jmdmahdi/Weather-Station/README.md

# Weather Station
Weather station (measure pressure, temperature, light intensity, wind speed and direction) with STM32 MCU (in STM32CubeIDE)
