jmdmahdi/Weather-Station/Desktop App/README.md

# Desktop App
Weather station desktop app with Python, PyQt5, and PyUSB

Gather data on the receiver side (station) form STM32 MCU through USB protocol
