jmdmahdi/Weather-Station/Codes/Sensor/README.md

# Sensor
Weather station sensor side (transmitter)

STM32 MCU collects data from sensors and transmits them through Lora module to the station
