jmdmahdi/Weather-Station/Codes/Station/README.md

# Staion
Weather station side (receiver)

STM32 MCU collects receive data from LoRa module and transmit it to the desktop app through USB protocol
