jmdmahdi/Weather-Station/Report/Assets/Diagram.pdf

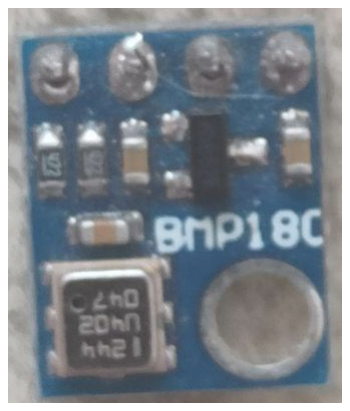
[picture p1: figure]
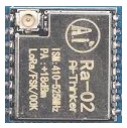
[picture p2: figure]
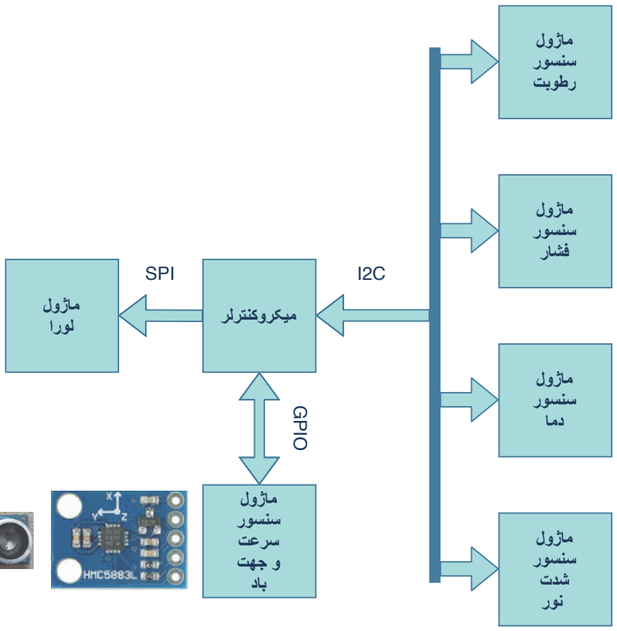
[picture p3: figure]
ماژول; میکروکنترلر; لورا; ماژول سنسور دما; ماژول سنسور فشار; ماژول سنسور رطوبت; ماژول سنسور شدت نور; ماژول سنسور سرعت جھت; باد; GPIO; SPI
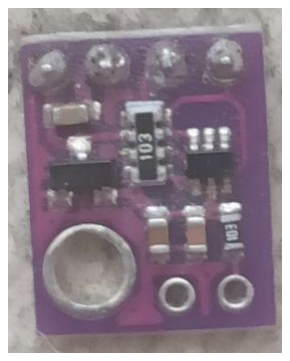
[picture p4: figure]
