jmdmahdi/Weather-Station/Report/Assets/USB.pdf

Host

Hub | Device 1 | Device 2
Device 3 | Device 4
