jmdmahdi/Weather-Station/Report/main.pdf

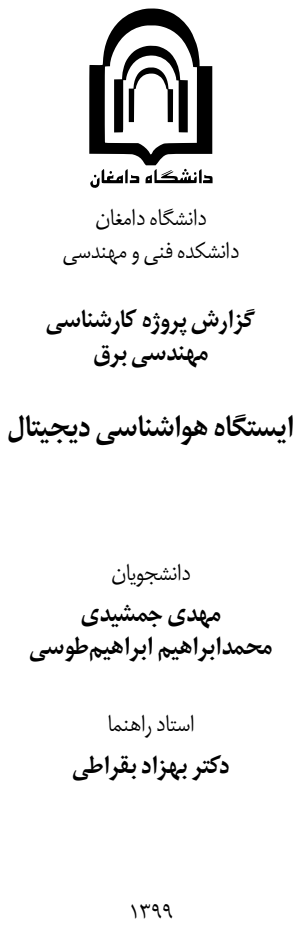
[picture p5: page 1]

دانشگاه دامغان
دانشکده فنی و مهندسی
گزارش پروژه کارشناسی
مهندسی برق
ایستگاه هواشناسی دیجیتال

دانشجویان
مهدی جمشیدی
محمدابراهیم ابراهیم طوسی

استاد راهنما
دکتر بهزاد بقراطی

## فهرست مطالب

### ۱ مقدمه ۱ ۲ اجزای سیستم ۱

### ۳ پروتکل های ارتباطی ۶

۷ | I

.۳ ۲ پروتکل C²

### ۴ پیاده سازی سیستم ۹ ۵ طراحی بردمدارچاپی ۱۱ ۶ نتایج ۱۲ ۷ نتیجه گیری ۱۳

اول

## ۱ مقدمه

ایستگاه هواشناسی، مرکزی مجهز به تجهیزات و ابزارهایی برای اندازه گیری های جوی است که به ارائه اطلاعات برای پیش بینی ً شامل دما، فشار هوا، رطوبت، سرعت باد، جهت باد و مقدار بارش است.
و مطالعه آب وهوا می پردازد. اندازه گیری انجام شده معمولا مشاهدات دستی حداقل یک بار در روز انجام می شود، درحالی که اندازه گیری خودکار حداقل یک بار در ساعت انجام می پذیرد. ایستگاه های هواشناسی معمولی مجهز به ابزارهای زیر هستند [۱]:
- رطوبت سنج برای اندازه گیری رطوبت
- فشارسنج برای اندازه گیری فشار جو
- دماسنج برای اندازه گیری دمای هوا
- پیرانومتر برای اندازه گیری تشعشعات خورشیدی
- باران سنج برای اندازه گیری میزان بارش باران در طی یک دوره زمانی مشخص
- تجهیزاتی نظیر بادسنج، پرچم باد یا جوراب باد برای اندازه گیری سرعت و جهت باد ایستگاه های پیشرفته تر همچنین ممکن است شاخص فرابنفش، رطوبت برگ، رطوبت خاک، دمای خاک، دمای آب در حوضچه ها، دریاچه ها، نهرها یا رودخانه ها و گاهی داده های دیگر را اندازه گیری کنند. به جز دستگاه هایی که نیازمند تماس مستقیم با عناصر مورداندازه گیری هستند (نظیر بادسنج)، دیگر سنسورها و دستگاه ها باید در محفظه ای به دوراز تابش مستقیم خورشید و وزش باد قرار بگیرند. ایستگاه های هواشناسی سینوپتیک (Synoptic (۲۴ ساعته به صورت خودکار هر سه ساعت به سه ساعت پارامترهای جوی
را پس از اندازه گیری و جمع آوری از طریق شبکه های مخابراتی منتقل می کنند. به طور مشابه ایستگاه هایی با نام متار (Metar( این کار را هر یک ساعت انجام می دهند. وظیفه این ایستگاه ها جمع آوری اطلاعات جوی از محدوده هایی وسیع و مخابره به ایستگاه های اصلی به منظور اطلاع از وضعیت حال و گذشته و پیش بینی شرایط آب و هوایی مناطق در آینده است. هدف این پروژه پیاده سازی نوعی ایستگاه هواشناسی سینوپتیک است که با تجهیزات ارزان و کم مصرف دیجیتالی پارامترهای جوی لازم را جمع آوری و به صورت بی سیم به ایستگاهی جهت ثبت و نمایش مخابره می کند. در این پروژه از میکروکنترلر (Microcontroller (ARM سری X10F32STM به عنوان هسته اصلی پردازش در هر دو سمت سنسور و ایستگاه و از ماژول لورا (LoRa (با چیپ 1278SX به منظور برقراری ارتباط بی سیم استفاده شده است.

## ۲ اجزای سیستم

این سیستم به دو دستگاه اصلی تقسیم می شود، یک دستگاه جهت جمع آوری اطلاعات جوی برروی یک میله در ارتفاع ۱۰ متری سطح زمین قرار می گیرد و اطلاعات جوی نظیر دما، رطوبت، فشار، شدت نور، سرعت و جهت باد را از سنسورهای مربوطه جمع آوری کرده و به صورت بی سیم به دستگاه دیگر، که در ایستگاه اصلی قرار دارد، مخابره می کند؛ سپس اطلاعات دریافت شده در سمت دستگاه دوم جهت ثبت و ذخیره به رایانه منتقل می شود. در اینجا به دستگاه اول که وظیفه جمع آوری اطلاعات جوی را دارد سنسور و دستگاه دوم که وظیفه دریافت اطلاعات مخابره شده و انتقال به رایانه را دارد ایستگاه می گوییم. بلوک دیاگرام کلی این سیستم و نحوه ارتباط بخش های مختلف با یکدیگر در شکل ۱ آمده است.

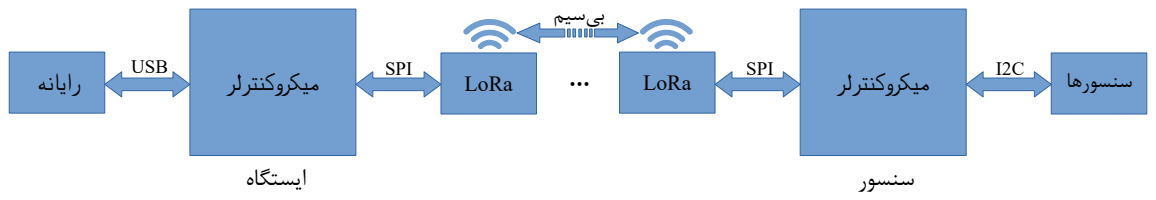
[picture p6: figure]
USB; میکروکنترلر رایانه; LoRa; SPI; میکروکنترلر SPI; سنسورها I2C; سنسور ایستگاه; بی‌سیم

شکل :۱ بلوک دیاگرام اجزای سیستم و نحوه ارتباط اجزای مختلف با یکدیگر.
.۲ ۱ میکروکنترلر
هسته اصلی پردازش در هر دو سمت ایستگاه و سنسور میکروکنترلر 6CBT103f32STM انتخاب شده است که با توجه به ،۲ اینترفیس۳USB۴ و ۳ عدد تایمر ۱۶ بیتی نیاز به حداقل ۱ عدد

،۱ ۲ عددSPI
I

موجود بودن در بازار ایران و دارا بودن ۲ عددC²
I) در سمت سنسور)، ۱ عدد SPI) در هر دو سمت)، اینترفیس USB) در سمت ایستگاه) و ۱ عدد تایمر (در سمت سنسور)
2C
را برآورده می کند. همچنین حالت Sleep و واحد RTC موجود در این میکروکنترلرها به کاهش مصرف انرژی در وقفه های سه ساعته کمک می کند؛ به طوری که استفاده از سیستم باتری و پنل خورشیدی را ممکن می سازد. .۲ ۲ ارتباط بی سیم
به طورکلی در این سیستم مصرف پایین انرژی به دلیل استفاده از سیستم باطری و پنل خورشیدی بسیار اهمیت دارد. استفاده ۵ به عنوان راه حلی ابتدایی برای ارتباط بی سیم، علاوه بر نداشتن صرفه اقتصادی مصرف انرژی زیادی را به
از شبکه تلفن همراه
سیستم تحمیل می کند. همچنین تضمینی برای وجود پوشش شبکه تلفن همراه در مناطقی که قرار است داده های جوی از آن جمع آوری شود وجود ندارد. ازاین رو بهترین رویکرد استفاده از گیرنده و فرستنده های رادیویی در باندهای فرکانسی بدون نیاز به ۶ به لطف مدولاسیون ⁷CSS که از آن بهره می برند دارای مصرف
مجوز (ISM (است. از میان گزینه های موجود ماژول های لورا ً با نیازهای ما سازگار است. توان پایین، ناحیه پوشش وصیع و نفوذپذیری مناسبی هستند که کاملا ماژول -02Ra LoRa با تراشه 1278Sx دارای رنج فرکانسی ۴۱۰ تا ۵۲۵ مگاهرتز، و توان انتقالی ماکسیموم ۱۸dBm وOOK۹ پشتیبانی می کند. برای ارتباط بی سیم در این پروژه از این ماژول استفاده شده

۸
است و از مدولاسیون هایLoRa،FSK است.
.۲ ۳ سنسورها
به منظور استخراج داده های جوی نظیر دمای هوا، رطوبت، فشار، شدت نور و... از سنسورهای دیجیتال استفاده می شود. این سنسورها علاوه بر کم مصرف بودن دارای دقت بالا و تأخیر پایینی در اندازه گیری پارامترهای موردنظر هستند. با دارا بودن این ً با سیستم تغذیه باتری و سلول خورشیدی سازگار هستند. ویژگی ها این سنسورها کاملا

.۲ .۳ ۱ فشارسنج
تغییرات فشار جوی یکی از عناصر مهم در پیش بینی وضعیت آب وهوا است. فشارسنج های جیوه ای از اواخر قرن ۱۶ جهت پیش بینی وضعیت آب وهوا مورداستفاده قرار می گرفت. به طورکلی تغییر فشار هوا رو به بالا نشان دهنده آسمان آفتابی، گرم و صاف

1
Inter-Integrated Circuit
2Serial Peripheral Interface

3
Interface
4Universal Serial Bus
5The Global System for Mobile Communications (GSM) 6LoRa (Long Range)
7Chirp Spread Spectrum
8Frequency Shift Keying
9On Off Keying

و تغییر فشار هوا رو به پایین نشان دهنده بارش باران، طوفان و آسمانی مملو از ابرهای باران زا است. علاوه بر این فشار هوا یکی از عوامل مؤثر در سنجش سرعت باد نیز به شمار می آید. سنسور استفاده شده برای این منظور ماژول سنسور 180BMP است که با مصرف جریان تنها در حد چند میکرو آمپر دقتی معادل با ۰٫۳ هکتوپاسکال۱ دارد و توانایی اندازه گیری فشار هوا در بازه ۳۰۰ تا ۱۱۰۰ هکتوپاسکال را دارا است. نحوه ارتباط با I است.

این ماژول از طریق رابط C²

.۲ .۳ ۲ شدت نور
شدت نور خورشید یکی از پارامترهای اصلی سنجش وضعیت آب وهوا است. از این سنسور جهت نشخیص ابری یا آفتابی بودن ً در کنار این سنسور از سنسور سنجش شدت
هوا می توان استفاده کرد. همچنین به دلیل اهمیت موضوع سلامت پوست، معمولا UV به منظور اطلاع رسانی شدت UV نیز استفاده می شود. جهت سنجش شدت نور از ماژول سنسور 44009MAX استفاده شده است که با ۰٫۶۵ میکرو آمپر مصرف جریان در هنگام کارکرد شدت نور در بازه ی ۰٫۰۴۵ لوکس تا ۱۸۸ هزار لوکس را اندازه گیری می کند. همچنین اینترفیس ارتباطی این ماژول رابط I می باشد.

سریالی C²

.۲ .۳ ۳ قطب نما
ً در ارتفاع ۱۰ متری زمین روی یک میله نصب می شود، قرار دادن دستگاه در
ازآنجایی که این دستگاه در سمت سنسور معمولا جهت جغرافیایی خاص، به جهت سنجش جهت باد، ممکن است دشوار باشد (یا حتی خیلی دقیق نباشد). باوجود سنسور قطب نما در این دستگاه (برخلاف برخی دستگاه های مشابه) دیگر نیازی به نصب دستگاه در جهت جغرافیایی خاص نخواهد بود. سنسور استفاده شده برای این منظور سنسورL5883QMC است. که با ماکسیموم ۱۰۰ میکرو آمپر جریان مصرفی می توان
I است.

به دقت یک تا دو درجه در جهت یابی رسید. همچنین طریقه ارتباط این سنسور با میکروکنترلر از طریق رابط C²

.۲ .۳ ۴ دما و رطوبت هوا
ً به طور مستقیم پارامتر دمای هوا نیز در اطلاع رسانی وضعیت و درکتار وضعیت آسمان (ابری، آفتابی، بارانی و... بودن) معمولا ً به طور مستقیم
پیش بینی آب وهوا نقش ایفا می کند. در کنار این موارد رطوبت هوا نیز، علاوه بر نقشی که در پیش بینی دارد، معمولا به سمع و نظر مخاطبین می رسد. علاوه این رطوبت نسبی هوا در کنار دمای هوا نقش مهمی در رسیدن به آسایش حرارتی در بدن انسان (و موجودات) دارد. به طوری کلی در دمای هوای بالاتر به رطوبت نسبی کمتری نسبت به دمای هوای پایین تر برای رسیدن به سطح آسایش حرارتی نیاز است [۲]. ماژول سنسور 10AHT دما و رطوبت نسبی هوا را با دقت ۰٫۰۱ درجه سلسیوس۲ و ۰٫۰۲۴ درصد با تنها ۳٫۳ میکرو وات مصرف توان اندازه گیری می کند. همچنین این ماژول در رطوبت ۰ تا ۱۰۰ درصد و دمای -۴۰ تا ۱۰۰ درجه ی سلسیوس I است.

قابل استفاده است. خروجی این ماژول نیز سیگنال دیجیتال ارتباطی C²

.۲ .۳ ۵ شدت و جهت باد
ً در این کاربرد دو روش سنجش مکانیکی و آلتراسونیک ۳ مورداستفاده
روش های مختلفی برای سنجش شدت باد وجود دارد، عمدتا قرار می گیرد. در سنجش شدت و جهت باد در روش مکانیکی از دو ابزار که به صورت مستقل کار می کنند (در برخی موارد این دو ابزار در قالب یک دستگاه در کنار هم قرار می گیرند) استفاده می شود، به طوری که یک ابزار برای سنجش شدت و ابزاری دیگر برای تعیین جهت، مورداستفاده قرار می گیرد. هر دو دستگاه دارای قطعات متحرک اند و یکی با داشتن پره هایی شبیه به دم هلی کوپتر با وزرش باد در جهت وزش قرار می گیرد و دیگری دارای پره هایی است که با وزش باد پره ها همانند پره های توربین به حرکت درمی آید که با توجه به سرعت چرخش پره ها سرعت باد قابل اندازه گیری است. در اندازه گیری های این دستگاه ها

1Hectopascal (hPa)
2Celsius
3Ultrasonic

محدودیت هایی وجود دارد و اغلب این نوع ابزارها در وزش باد ملایم عملکرد صحیحی از خود نشان نمی دهند. همچنین در اندازه گیری زاویه وزش ممکن است محدود به اندازه گیری زوایای خاصی باشند. در روش اندازه گیری شدت و جهت باد با آلتراسونیک اندازه گیری ها می تواند در قالب تنها یک دستگاه، بدون قطعات متحرک
و با دقتی بالاتر انجام پذیرد. در این روش ۲ فرستنده و گیرنده آلتراسونیک همان طور که در شکل ۲ نشان داده شده است روبروی یکدیگر در فاصله مشخص d قرار داده می شوند.

فرستنده گیرنده

d

امواج آلتراسونیک

شکل :۲ نحوه قرارگیری فرستنده و گیرنده آلتراسونیک.
فرستنده امواج صوتی با فرکانس ۴۰ کیلوهرتز (که برای گوش انسان قابل شنیدن نیست) تولید می کند. فاصله زمانی بین ارسال امواج صوتی از فرستنده و دریافت این امواج در گیرنده اندازه گیری می شود. با توجه به رابطه ،۱ سرعت v با داشتن فاصله d و زمان تأخیر بین ارسال موج صوتی در فرستنده و دریافت آن در گیرندهt، قابل اندازه گیری است.

v =

d
t

(۱)

سرعت v به دست آمده از این رابطه مطابق رابطه ۲ متشکل از سرعت صوت vs و سرعت باد vwx است [۳].

v = vs + vwx | (۲)
درصورتی که وزش باد در جهت موافق حرکت امواج صوتی باشد زمان تأخیر در دریافت امواج نسبت به حالی که باد نوزد کمتر شده و درنتیجه سرعت v نسبت به حالتی که باد نوزد افزایش می یابد (یعنی علامت vwx مثبت بوده و vwx + vs = v(. درصورتی که وزش باد در خلاف جهت حرکت امواج صوتی باشد زمان تأخیر در دریافت امواج نسبت به حالتی که باد نوزد بیشتر شده و درنتیجه سرعت v کاهش می یابد (یعنی علامت vwx منفی بوده و vwx − vs = v(. با داشتن سرعت صوت vs، فاصله d و محاسبه زمان tمی توان با توجه به معادلات۱ و ۲ سرعت باد vwx و جهت باد (علامت سرعت vwx (روی یک محور مطابق رابطه ۳ به دست آورد.

vwx =

d
t
− vs | (۳)
به منظور سنجش شدت و جهت باد در دو بعد می توان دو فرستنده و گیرنده دیگر بر روی محوری عمود بر محور متصل کننده فرستنده و گیرنده فعلی قرارداد و با محاسبه دو بردار سرعت، بردار سرعت برآیند را به دست آورد. اگر نحوه قرارگیری فرستنده و گیرنده ها مطابق شکل ۳آ باشد در این صورت صفحه مختصات متناظر با آن مطابق شکل ۳ب خواهد بود. اندازه vw و زاویه θ بردار سرعت باد از طریق روابط ۴ به دست می آیند.

vw =

√
v

2
wx + v

2
wy

θ = tan−1

(
vwy
vwx) | (۴)

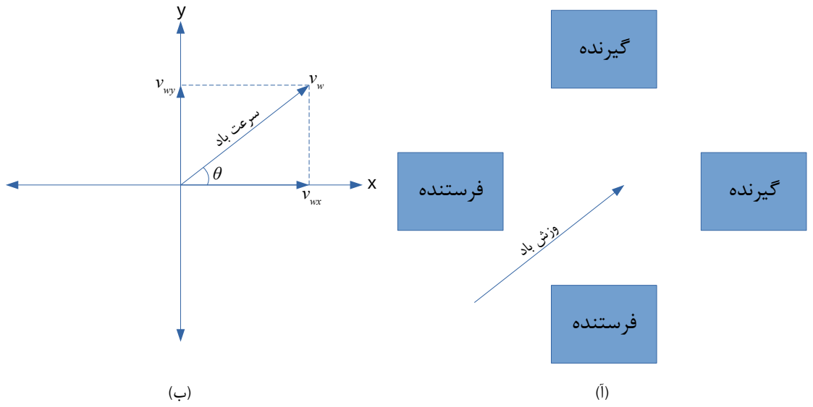
[picture p7: figure]
سرعت باد; گیرنده فرستنده; فرستنده; گیرنده; وزش باد

شکل :۳ نحوه قرارگیری فرستنده و گیرنده آلتراسونیک دو محوره و نمودار متناظر با آن ها. جدول :۱ ضرایب محاسبه سرعت صوت (فرمول ۵) [۴]. ضرایب
331.5024 | a0
0.603055 | a1
−0.000528 | a2
51.471935 | a3
0.1495874 | a4
−0.000782 | a5
−1.82 × 10−7 | a6
3.73 × 10−8 | a7
−2.93 × 10−10 | a8
−85.20931 | a9
−0.228525 | a10
5.91 × 10−5 | a11
−2.835149 | a12
−2.15 × 10−13 | a13
29.179762 | a14
0.000486 | a15
سرعت صوت vs به عنوان تابعی از دما، فشار و کسر مولی رطوبت و کربن دی اکسید، با استفاده از رابطه ۵ قابل محاسبه است [۴]. ثوابت1a تا 15a در جدول ۱ آمده اند.

vs (τ, p, xw, xc) =a0 + a1τ + a2τ

2 +

(
a3 + a4τ + a5τ

2

)
xw
+

(
a6 + a7τ + a8τ

2

)
p +

(
a9 + a10τ + a11τ

2

)
xc
+ a12x

2
w + a13p

2 + a14x

2
c + a15xwpxc

(۵)

xc کسر مولی

که τ دمای هوا (برحسب درجه سلسیوس)، p فشار هوا (برحسب پاسکال)، xw کسر مولی بخارآب در هوا و 10−6 × 400 در نظر می گیریم. کسر مولی بخارآب در هوا xw از رابطه ۶ xc را ثابت و برابر

کربن دی اکسید در هوا است.

به دست می آید [۵].

xw =

hfpsv
100p

(۶)

که h درصد رطوبت هوا، psv فشار اشباع بخارآب در هوا و f ضریب تقویت است و از طریق روابط ۷ و ۸ محاسبه می شوند .[۶]

f = 1.00062 + 3.14 × 10−8

p + 5.6 × 10−7
τ

2
(۷)

psv = exp (
1.2811805 × 10−5T

2 − 1.9509874 × 10−2T

+34.04926034 − 6.3536311 × 10³

/T) | (۸)

که در این روابط T دمای محیط برحسب کلوین۱ است، یعنی:

T = τ + 273.15 | (۹)

## ۳ پروتکل های ارتباطی

قطعات الکترونیک نیز همانند انسان ها برای ارتباط با یکدیگر باید از یک زبان واحد قابل فهم برای هر دو طرف استفاده کنند که به این زبان ها پروتکل های ارتباطی گفته می شود. در این پروژه نیز همانند اکثر پروژه های الکترونیکی از تعدادی از این پروتکل ها برای برقراری ارتباط بین قطعات الکترونیکی مختلف (سنسورها، فرستنده-گیرنده های رادیویی و میکروکنترلر) استفاده شده است. در زیر اطلاعات کلی هر یک از پروتکل های ارتباطی استفاده شده در این پروژه آمده است. .۳ ۱ پروتکل SPI
این پروتکل یک رابط ارتباط سریالی سنکرون۲ (همزمان) چهار سیم است که برای ارتباط بین تنها یک Master و چندین Slave ۳)، خط ارسال داده
می تواند مورداستفاده قرار گیرد. خطوط ارتباطی بین Master و Slave شامل خط سیگنال کلاک (SCLK ۶ یا CS۷(.

از Master به Slave) MOSI۴(، خط ارسال داده از Slave بهMaster) MISO۵ (و خط انتخاب Slave) SS ً نیاز به یک پین انتخاب گر (SS یا CS (مجزا در سمتMaster خواهد بود.
در حالتDuplex Full به ازای هر Slave معمولا نحوه اتصال دستگاه های SlaveبهMaster در شکل ۴ آمده است. سیگنال کلاک همواره توسط Master تولید و به ازای هر سیگنکال کلاک یک بیت داده منتقل می شود. ازاین رو ارسال داده از Slave بهMaster به طور تصادفی و در هرلحظه ممکن نیست و تنها Slave می تواند در لحظاتی کهMaster درخواست می کند و سیگنال کلاک را تولید می کند داده را برروی خط MISO ارسال کند. البته به دلیل وجود خطوط مجزای ارسال و دریافت داده، ارسال و دریافت همزمان داده نیز ممکن است. همچنین در این پروتکل دستگاه های Slave به تنهایی نمی توانند با یکدیگر ارتباط برقرار کنند.

1Kelvin

2
synchronous
3Serial Clock
4Master Out Slave In
5Master In Slave Out
6Slave Select
7Chip Select

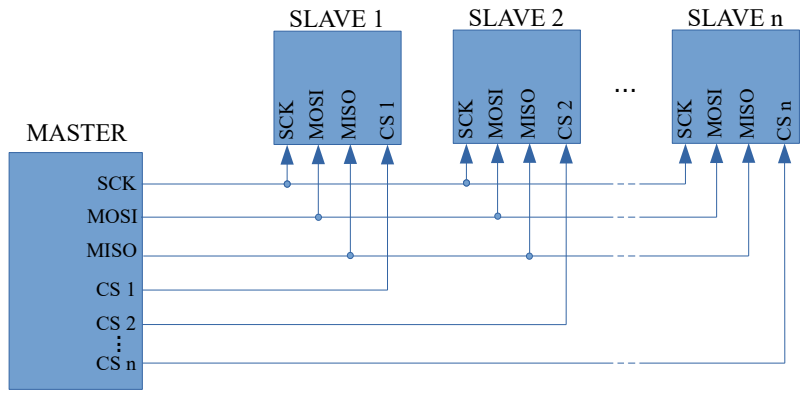
[picture p8: figure]
MASTER; SLAVE 1; SCK; MOSI; MISO; MIS; SLAVE 2; SLAVE n

شکل :۴ نحوه اتصال Slaveها بهMaster در حالت Duplex Full

به جهت ارسال داده، Master از طریق قراردادن خط SS) یا CS (در حالت low انتخاب می کند که با کدام Slave
می خواهد ارتباط برقرار کند. وضعیت خط را تا پایان فرآیند ارسال و دریافت داده در همین حالت (low (نگهمیدارد. در همین حال سیگنال کلاک را روی خط SCLK متناسب با طول داده ارسالی قرار می دهد (ماکسیموم فرکانس کلاک بستگی به ماکسیموم مقدار قابل شناسایی توسط Slave دارد) و داده ارسالی را نیز متناسب با کلاک روی خط MOSI قرار می دهد (قرار دادن داده روی لبه بالارونده یا پایین رونده و همچنین ارسال از بیت MSB یا LSB بستگی به Slave دارد)؛ اگر قرار باشد Slave دیتایی در پاسخ به دیتای دریافتی ارسال کند (این امر باید از قبل مشخص باشد چراکه همان طور که گفته شد مسئول تولید کلاک فقط Master است) باید Master کلاک هایی متناسب با دیتای مورد انتظار برای دریافت را روی خط SCLK تولید کند و دیتای مربوطه را از روی خط MISO بخواند.

I

.۳ ۲ پروتکل C²
I رابط سریالی سنکرون دو سیم است که علاوه بر پشتیبانی از چندین Slave قابلیت پشتیبانی از چند Master را

پروتکل C²
نیز دارا می باشد (البته Masterها قادر به برقراری ارتباط با یکدیگر نیستند و از خطوط بأس به طور همزمان نمی توانند استفاده
۲) استفاده می شود. نحوه اتصال
۱) و سیگنال دیتا (SDA
کنند). در این پروتکل برای ارتباط از تنها دو خط سیگنال کلاک (SCL دستگاه ها در این پروتکل در شکل ۵ آمده است.

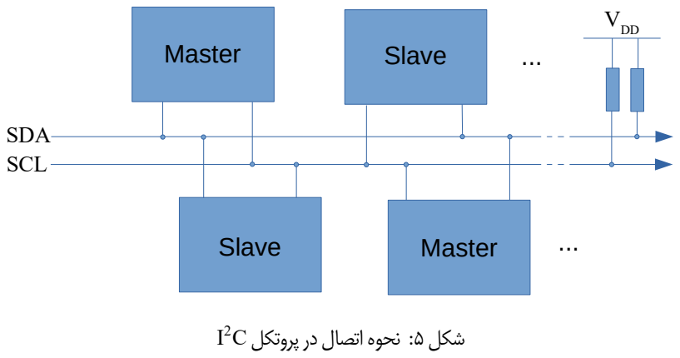
[picture p9: figure]
SDA SCL; Master; Slave; VDD; شکل :۵ نحوه اتصال در پروتکل C²

در این پروتکل نیز همانند پروتکل SPI سیگنال کلاک توسط Master کنترل می شود. اعلام شروع ارسال داده با بالا نگهداشتن خط SCL و پایین کشیدن خط SDA انجام می شود. اگر دو Master به طور همزمان قصد تبادل داده با Slaveها

1Serial Clock Line
2Serial Data Line

را داشته باشند هرکدام که زودتر SDA را پایین بکشید اجازه استفاده از خط را دارد و Master دیگر باید تا پایان تبادلاتMaster اول صبر کند.
برای انتقال داده پس از اعلام شروع ارسال توسطMaster، ۷ بیت آدرسSlave که قرار است با آن ارتباط برقرار شود ارسال
می شود و پس ازآن یک بیت write/read ارسال می شود تا Slave از قصدMaster برای خواندن (سطح منطقی ۱) یا نوشتن (سطح منطقی ۰) مطلع شود (امکان ارتباط با Slave با آدرس های ۱۰ بیتی نیز وجود دارد که نحوه ارسال آن کمی متفاوت است ولی فرآیندهای دیگر در دریافت و ارسال داده ها یکسان است). در تمام طول ارسال و دریافت داده سیگنال کلاک نیز به طور منظم روی خط SCL تولید می شود. بعد از ارسال آدرس توسط Master، Slaveها آدرس ارسالی را با آدرس خود مقایسه کرده و درصورتی که با آن مطابقت داشت بیت تصدیق (ACK (را با پایین کشیدن SDA تا قبل از کلاک نهم ارسال می کنند. اگر بیت تصدیق در این زمان ارسال نشود و SDA در سطح high بماند ارسال داده متوقف می شود چراکه عدم دریافت بیت تصدیق نشان دهنده عدم وجود Slave موردنظر روی خط و یا عدم توانایی Slave در رمزگشایی داده ارسالی است. پس از ارسال آدرس و دریافت تصدیق از سمت Slave با توجه به بیت write/read ارسالی، داده توسط Slave) درحالت خواندن) و یا Master) در حالت نوشتن) روی خط SDA قرار داده می شود. بعد از ارسال هر ۸ بیت داده نیز لازم است بیت تصدیق دریافت داده ها (ACK (از طرف دریافت کننده داده ها ارسال شود. بعد از ارسال یا دریافت تمام داده ها باید وضعیت توقف اعلام شود تا دیگر Masterها بتوانند پس ازآن از خط استفاده کنند. اعلام وضعیت توقف با یک تغییر وضعیت SDA از سطح منطقی ۰ به ۱ و پس ازآن یک تغییر وضعیت از سطح منطقی ۰ به ۱ روی خط SCL انجام می شود. .۳ ۳ پروتکل USB
پروتکلUSBیک پروتکل ارتباطی سریال آسنکرون۱ (ناهمزمان) دو سیم است که ارتباطی بین چندین دستگاه جانبی یا Device و دستگاه اصلی یا Host را فراهم می کند. USB توسط یک گروه متشکل از شرکت های فعال در زمینه رایانه و الکترونیک ایجاد شد که هدف ساخت پروتکل سریال همه منظوره برای اتصال لوازم جانبی به رایانه را داشتند. به دلیل همه منظوره بودن USB استفاده از این پروتکل دارای جزئیات بسیار زیادی است و برخلاف دو پروتکل قبلی راه اندازی این پروتکل ممکن است زمان بر باشد. در این پروژه از این پروتکل برای ارتباط دستگاه سمت ایستگاه با رایانه و همچنین تأمین تغذیه آن استفاده می شود. نحوه اتصال دستگاه ها بهHost در شکل ۶ آمده است.

Host

Hub | Device 1 | Device 2
Device 3 | Device 4

شکل :۶ نحوه اتصال دستگاه های جانبی به دستگاه اصلی در پروتکل USB به طورکلی برای ارتباط دستگاه های جانبی با دستگاه اصلی، دستگاه جانبی نیازمند دارا بودن Class Device مشخص و شناخته شده برای دستگاه اصلی است. پیاده سازی دیوایس کلاس های اختصاصی به خاطر پیچیدگی هایی که این پروتکل دارد ً استفاده از دیوایس کلاس های آماده (و لایبرری های متناطر با آن) برای
امری بسیار زمان بر خواهد بود به همین دلیل معمولا

1Asynchronous

ساخت دستگاه های جدید مناسب ترین روش ممکن است (این کار همچنین امر دریافت گواهی های سخت افزاری و نرم افزاری USB را نیز تسهیل می کند).
در این پروتکل ۴ نوع انتقال داده وجود دارد. انتقال Control که تنطیمات و مشخصات دستگاه و دستورات را منتقل
می کند. انتقال Isochronous که برای انتقال داده هایی که زمان بندی در آنها اهمیت دارد نظیر صدای میکروفون و تصویر وب کم مورداستفاده قرار می گیرد. انتقال Bulk که برای ارسال داده های حجیم تر به صورت یکجا مورداستفاده قرار می گیرد مانند انتقال تصویر برای پرینت و یا اسکن و یا انتقال داده های ذخیره شده روی یک فلش مموری. انتقال Interrupt که داده هایی با در کلاس HID۱

ً
ً توسط موس، کیبرد و جواستیک (Joystick (و عموما حجم بسیارکم و اهمیت زیاد را جابجا می کند که معمولا مورداستفاده قرار می گیرد.
در این پروتکل لازم است دستگاه اصلی از تمامی جزئیات کارکرد و مشخصات دستگاه جانبی مطلع شود. مشخصات کلی دستگاه مثل ورژن USB مورداستفاده، شناسه ونام سازنده، شناسه ونام دستگاه و مشخصات کلاس دستگاه در بخشی با عنوان Descriptor Device با فرمتی خاص و مشخص به اطلاع رایانه می رسد. بخش دیگری با عنوان -Configu Descriptors ration بیان کننده نحوه تغذیه و ماکسیموم توان موردنیاز دستگاه متصل به USB است. بخش Interface Descriptors نیز بیان کننده ویژگی های کلاس دستگاه است و شامل چندین Descriptors Endpoint می شود که برای ً یک رجیستر یا
انجام آن ویژگی ها موردنیاز هستند. برای هر Endpoint در سمت دستگاه جانبی ازنظر سخت افزاری معمولا مموری تعریف می شود که دیتا با توجه به مشخصات هرEndpoint از آن خوانده می شود یا در آن نوشته می شود هرEndpoint فقط مسئول یکی از اعمال خوانده شدن یا نوشته شدن است و برای هر دو عمل خواندن و نوشتن به دو Endpoint نیاز است. ماکسیموم می توان ۱۶ Endpoint تعریف کرد، Endpoint صفر رزرو و برای مشخصات کنترلی استفاده می شود دیگر Endpoint ها را می توان با مشخات موردنیاز تعریف کرد. به طور مثال در این پروژه از کلاسCDC۲ استفاده شده است (که در کارت های شبکه و مودم ها نیز مورداستفاده قرارمی گیرد). برای تبادل داده با رایانه در این کلاس از ارسال نوع Bulk استفاده می شود. پس اینترفیسی از نوع CDC باید یک Endpoint با دیتاتایپ Bulk به عنوان ورودی و یک Endpoint دیگر با دیتاتایپ Bulk به عنوان خروجی داشته باشد. آدرس Endpoint ورودی01x0 وEndpointخروجی81x0 تنظیم شده اند. همچنین چون قصد استفاده ازUSBدر حالتSpeed Fullراداریم ماکسیموم سایز بسته ارسالی نیز ۶۴ بایت تنظیم شده است.

## ۴ پیاده سازی سیستم

عملکرد کلی سیستم جمع آوری داده ها در سمت سنسور، ارسال اطلاعات از طریق لورا به سمت ایستگاه و نمایش اطلاعات دریافت شده در سمت ایستگاه برروی رایانه است. به طورکلی این سیستم به دو بخش سنسور و ایستگاه تقسیم می شود که بخش ایستگاه خود به دو بخش دستگاه گیرنده و برنامه دسکتاپ (Desktop (قابل تقسیم است. در سمت سنسور اجرای فرآیندها به طریق زیر است:
I با سنسور
- بعد از روشن شدن دستگاه و فعالسازی بخش های موردنیاز (peripherals(، میکروکنترلر از طریق C² 180BMP ارتباط برقرار می کند و ضرایب کالیبراسیو را از سنسور 180BMP می خواند این ضرایب برای محاسبه دما و فشار مورداستفاده قرار می گیرند [۷]. Iبا سنسور 44009MAXمقدار رجیستر تنظیمات این سنسور را 00x0 تنظیم
- میکروکنترلر با برقراری ارتباط از طریقC² می کند. در این حالت سنسور در پایین ترین سطح مصرف توان خوده قرار می گیرد و هر ۸۰۰ میلی ثانیه یکبار میزان شدت نور را اندازه گیری می کند [۸]. Iبا سنسور L5883HMC و تنظیم رجیستر تنظیمات، سنسور در حالت آماده به کار و نرخ
- با برقراری ارتباطی از طریقC² نمونه برداری ۵۰ هرتز قرار می گیرد [۹].

1Human interface device
2Communications Device Class

- رجیسترهای تنظیمات ماژول LoRa با برقراری ارتباط از طریق SPI تنظیم شده و این ماژول در حالت آماده به کار قرار می گیرد. فرکانس این ماژول روی ۴۳۳ مگاهرتز، توان آن روی ۲۰ dBm، ضریب بخش آن روی ۱۰ و پهنای باند آن روی همین تنظیمات فرکانس،

ً
۳۱٫۲ کیلوهرتز تنظیم می گردد (به منظور دریافت اطلاعات ارسالی در سمت ایستگاه نیز دقیقا پهنای باند و ضریب پخش باید اعمال شوند) [۱۰].
- برنامه وارد حلقه اصلی کار خود شده و دما و فشار را با استفاده از سنسور 180BMP اندازه گیری می کند.
- پس از اندازه گیری شدت نور با استفاده از سنسور 44009MAX]۸ [و اندازه گیری رطوبت هوا به وسیله سنسور 10AHT [۱۱]، جهت جغرافیایی توسط سنسور L5883QMC] ۹ [به دست می آید.
- سرعت باد روی دو محور x و y با استفاده از سنسور 05HCSR و با توجه به رابطه ی ۳ محاسبه می شود. سپس زاویه و شدت باد با توجه به سرعت باد روی هر دو محور با توجه به رابطه ۴ به دست می آید.
- اطلاعات جمع آوری و محاسبه شده از طریق ماژول لورا برای گیرنده سمت ایستگاه ارسال می شود. ۲ میکروکنترلر از حالت
- میکروکنترلر و سنسورها در حالت توقف۱ قرار داده می شوند و پس از سه ساعت با رخ دادن آلارم توقف خارج شده و فرآیند دریافت و ارسال داده ها را تکرار می کند.
- پس از هر بار خارج شدن از حالت توقف، آلارم بعدی برای سه ساعت بعد تنظیم می شود. در سمت ایستگاه نیز فرآیند زیر اجرا می شود:
- با اتصال دستگاه از طریق کابلUSB به رایانه میکروکنترلر پس از فعال سازی بخش های موردنیاز، از طریقSPI با ماژول ژول لورا را در حالت

ٰ
لورا ارتباط برقرار کرده و رجیسترهای تنظیمات را با اطلاعات مشابه با سمت سنسور پر می کند و ما دریافت اطلاعات بدون توقف ۳ قرارمی هد [۱۰].
- میکرو به حلقه اصلی کار خود واردشده و پس از چک کردن وجود دیتای دریافتی در ماژول لورا، در صورت عدم وجود دیتا به حالت خواب ۴ رفته و تا زمان دریافت دیتا در همان حالت باقی می ماند.
- با دریافت دیتا توسط ماژول لورا وقفه ای خارجی رخ داده و میکرو را از حالت خواب بیدار می کند.
- میکرو کنترلر با برقراری ارتباط از طریق SPI با ماژول لورا دیتای دریافت شده را خوانده و پس از بررسی یکسان بودن شناسه دریافت کننده با شناسه خود آن را از طریق USB به رایانه ارسال می کند.
- در صورت عدم وجود دیتاهای دیگر، میکرو کنترلر به حالت خواب رفته و تا رخ دادن وقفه بعدی، که نشان دهنده دریافت اطلاعات توسط ماژول لورا است، در همان حال باقی می ماند. برنامه دسکتاپ که با زبان Python نوشته شده است، متشکل از سه بخش Home، Charts و Log می باشد. در بخش Home اطلاعات آخرین دیتای دریافت شده به نمایش درمی آید. در بخش Charts نمودارهای دیتاهای دریافتی در بازه قابل تعیین توسط کاربر به نمایش درمی آید. تمام رخدادهایی که در ارتباط با دستگاه رخ می دهد نظیر دریافت دیتای جدید و یا اتصال یا قطع اتصال دستگاه در تب Log با ذکر زمان لیست می شوند. نحوه عملکرد برنامه دسکتاپ به شرح زیر است: ،۵ که با 5PyQt پیاده سازی شده است، را برعهده
- با اجرای برنامه Thread اصلی وظیفه ترسیم رابط گرافیکی برنامه می گیرد.

1Stop
2Alarm
3Continuously
4Sleep
5Graphical user interface (GUI)

- در همین حین Thread دیگر به کمک کتابخانه libusb مسئول بررسی وضعیت اتصال دستگاه به رایانه و دریافت اطلاعات ارسالی از دستگاه می شود.
- در صورت تغییر وضعیت اتصال و یا دریافت اطلاعات، مشخصات آن در تبLog ثبت می شود و برای کاربر قابل مشاهده خواهد بود.
- هنگام دریافت اطلاعات جدید از طریق USB علاوه بر نمایش در تب اصلی برنامه، به روزرسانی تبCharts با اطلاعات جدید و ثبت رخ داد در تبLog، مشخصات کامل آن در دیتابیسSQLite در کنار فایل اجرایی برنامه نیز ذخیره می شود.
- در تب Charts با انتخاب بازه زمانی، نمودارها باتوجه به اطلاعات ثبت شده آن بازه زمانی در دیتابیس بروز می شوند.

## ۵ طراحی بردمدارچاپی

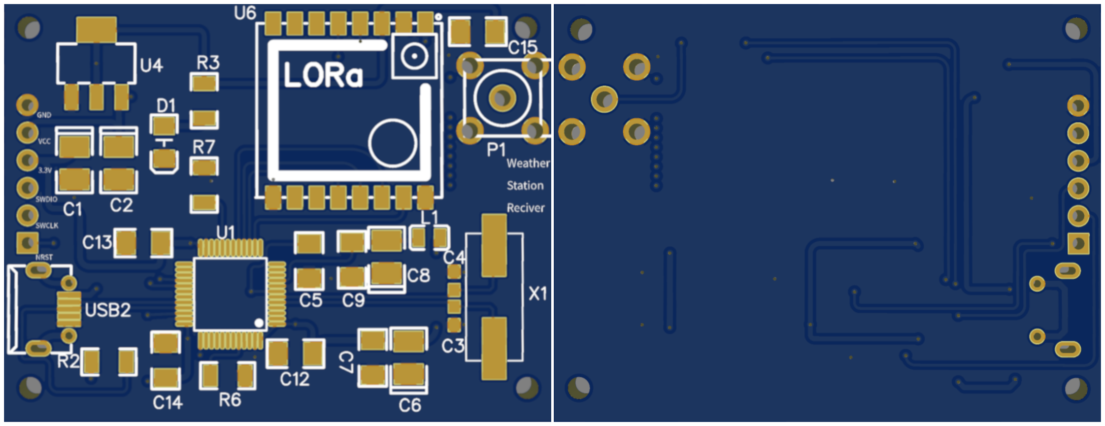
[picture p10: figure]

(آ) پشت برد سمت ایستگاه (ب) روی برد سمت ایستگاه

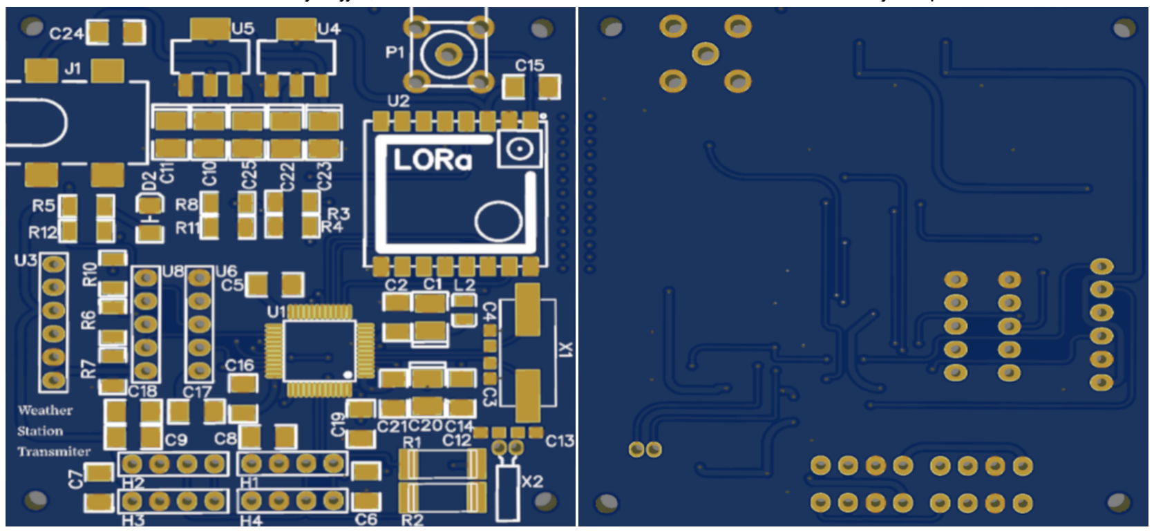
[picture p11: figure]

(ج) پشت برد سمت سنسور (د) روی برد سمت سنسور شکل :۷ تصاویر بردمدارچاپی طراحی شده برای هر دو سمت ایستگاه و سنسور. بردمدارچاپی۱ بردی است که با کانکتور و ترک هایی که روی آن قرار دارد قطعات را به طور الکتریکی به یکدیگر متصل می کند.

1Printed Circuit Board (PCB)

ً از جنس فیبرشیشه 4FR و لایه های مسی نازک که در یک یا دو طرف
بردمدارچاپی به طورکلی متشکل از هسته ای محکم معمولا آن قرار دارند می شود. ترک ها و پدها روی لایه های مسی و پس از حل کردن مس سایر بخش ها در اسید به وجود می آیند. برای محافظت از تماس ناخواسته ترک های مسی با قطعات و ذرات رسانا و همچنین جدا نمودن محل های لحیم کاری از سایر بخش ها، ً به رنگ سبز است.
بر روی لایه مسی لایه ی mask Solder قرار می گیرد که معمولا یکی از موارد مهم در مرحله طراحی بردمدارچاپی توجه به تأثیرات نویز در مدار و تلاش به کاهش اثرات آن است. نویزها
می تواند به دو صورت الکتریکی (در اثر خاصیت خازنی بین دو هادی) و مغناطیسی (در اثر خاصیت سلفی هادی) به وجود بیایند. منابع اصلی نویز سیگنال های پرودیک با فرکانس بالا نظیر زوج سیم های تفاضلی (+D و -D موجود در USB (یا سیگنال های ساعت۱ هستند.
با عبور جریان از یک هادی میدان مغناطیسی در اطراف آن به وجود می آید و در صورت وجود هادی ای دیگر در نزدیکی
آن میدان تولیدشده روی آن تأثیر گذاشته و باعث ایجاد جریان در هادی دوم می شود. همچنین وجود اختلاف پتانسیل بین دو هادی مجاور سبب ایجاد میدان الکتریکی شده و تغییرات پتانسیل یک هادی روی دیگری همانند صفحات یک خازن اثر می گذارد. کاهش طول هادی ها یکی از عوامل مؤثر در کاهش این نوع نویزها است. استفاده از خازن های کوپلاژ برای میکروکنترلر [۱۲]، استفاده از فیلترهای RC و LC، استفاده از Polygon) یا Pour (و استفاده از انواع شیلد و محافظ های زمین شده، از روش ها کاهش انواع نویز هستند که در طراحی بردمدار چاپی باید به آن ها توجه کرد. بردهای این پروژه نیز مطابق با این نکات طراحی شده اند. تصویر بردمدارچاپی طراحی شده این پروژه در شکل ۷ آمده است.

## ۶ نتایج

خروجی اطلاعات جمع آوری و مخابره شده توسط دستگاه بر روی رایانه و به کمک برنامه ساخته شده به همین منظور در سمت ایستگاه قابل مشاهده خواهد بود. جهت انجام بررسی های جزئی و ابتدایی به جهت پیش بینی وضعیت آب و هوایی بر روی دیتاهای دریافتی، می توان از نمودار دیتاهای دریافتی که در تب Charts برنامه قائل مشاهده است استفاده نمود. همچنین مشخصات و

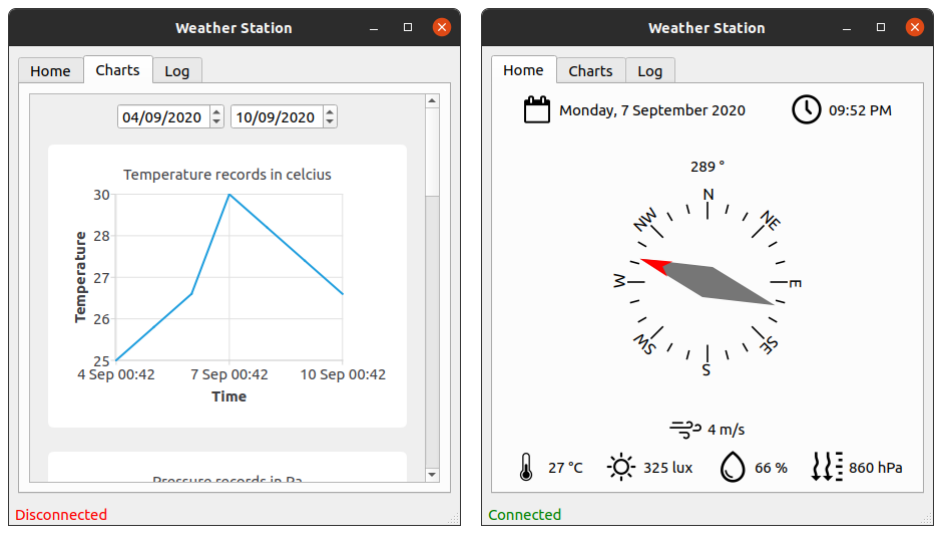
[picture p12: figure]

(آ) نمایش آخرین دیتاهای دریافتی برنامه در تب Home.) ب) نمایش نمودارهای اطلاعات دریافت شده در تب Charts. شکل :۸ تصاویر محیط برنامه دسکتاپ.

1Clock

جزئیات آخرین دیتای دریافت شده نیز در تبHome این نرم افزار قابل مشاهده است. تصاویری از محیط برنامه در شکل ۸ آمده است.

## ۷ نتیجه گیری

در انجام تست های عملی مشخص شد برد مفید ماژول لورا علاوه بر وابستگی ای که به پارامترهای پهنای باند، ضریب پخش و توان دارد، به شدت به نوع آنتن وابسته است و نیازمند توجه ویژه ای به مسئله تطبیق امپدانس ترک های آنتن خروجی در طراحی بردمدارچاپی است. به دلیل در دسترس نبودن معیار دقیقی برای سنجش سرعت باد نتیجه گیری در مورد دقت اندازه گیری سرعت باد اشتباه است اما با انجام آزمایشات متعدد دقت اندازه گیری جهت باد با سرعت متوسط و در دمای اتاق ±۴ درجه به دست آمد. همچنین مشخص شد تغییر فاصله فرستنده و گیرنده های آلتراسونیک از یکدیگر و از زمین، عاملی مؤثر در تعیین دقت اندازه گیری و ماکسیموم سرعت قابل اندازه گیری است. به طوری که با نزدیک تر قرار دادن فرستنده و گیرنده (تا حداقل ۴ سانتی متر) سرعت قابل اندازه گیری ماکسیموم و دقت اندازه گیری مینیموم می شود.

سورس کد تمامی پخش های پروژه به صورت متن باز در وبگاه GitHub به نشانی زیر در دسترس است:

https://github.com/jmdmahdi/Weather-Station (https://github.com/jmdmahdi/Weather-Station)

## مراجع

[1] Wikipedia, “Weather station,” 2020. [Online; accessed August 13, 2020].
[2] S. Schiavon, T. Hoyt, and A. Piccioli, “Web application for thermal comfort visualization and calculation according to ASHRAE standard 55,” Building Simulation, vol.7, pp.321– 334, Dec. 2013.
[3] P. Chandran, R. Bhakthavatchalu, and P. P. Kumar, “Time of flight measurement system for an ultrasonic anemometer,” in 2016 International Conference on Control, Instrumentation, Communication and Computational Technologies (ICCICCT), pp.734–737, 2016.
[4] O. Cramer, “The variation of the specific heat ratio and the speed of sound in air with temperature, pressure, humidity, and co2 concentration,” The Journal of the Acoustical Society of America, vol.93, no.5, pp.2510–2516, 1993.
[5] K. Rasmussen, “Calculation methods for the physical properties of air used in the calibra-tion of microphones,” 1997.
[6] R. S. Davis, “Equation for the determination of the density of moist air (1981/91),” Metrologia, vol.29, no.1, pp.67–70, 1992.
[7] B. Sensortec, “Digital pressure sensor,” May 7th, 2015.
[8] M. Integrated, “Max44009 industry’s lowestpower ambient light sensor with adc,” 19- 5719; Rev 0; 1/11.
[9] Honeywell, “3-axis digital compass ic hmc5883l,” Form 900405 Rev E, 2013.

[10] SEMTEH, “Sx1276/77/78/79 137 mhz to 1020 mhz low power long range transceiver,” Rev. 4, 2015.
[11] ASAIR, “Aht10 technical manual,” V1.1, 2018.
[12] STMicroelectronics, “An2586 application note,” Doc ID 13675 Rev 7, 2011.
