jmdmahdi/Weather-Station/Report/Assets/loraData.pdf

شناسھ دستگاه فرستنده بخش اول

شناسھ دستگاه فرستنده بخش دوم

شناسھ دستگاه فرستنده بخش سوم

شناسھ دستگاه فرستنده بخش چھارم

0

15

23

31

8

16

8

جھت باد بخش اول

جھت باد بخش دوم

جھت باد بخش سوم

بھت باد بخش چھارم

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
