jmdmahdi/Weather-Station/Report/Assets/sensorData.pdf

شناسھ دستگاه فرستنده

شناسھ دستگاه گیرنده

دما

فشار

شدت نور

رطوبت

سرعت باد

جھت باد

31 | 0
| 32
| 64
| 96
| 128
| 160
| 192
| 224

63

95

127

159

192

223

255
