jmdmahdi/Weather-Station/Report/Assets/ultrasonic 2d axis.pdf

y

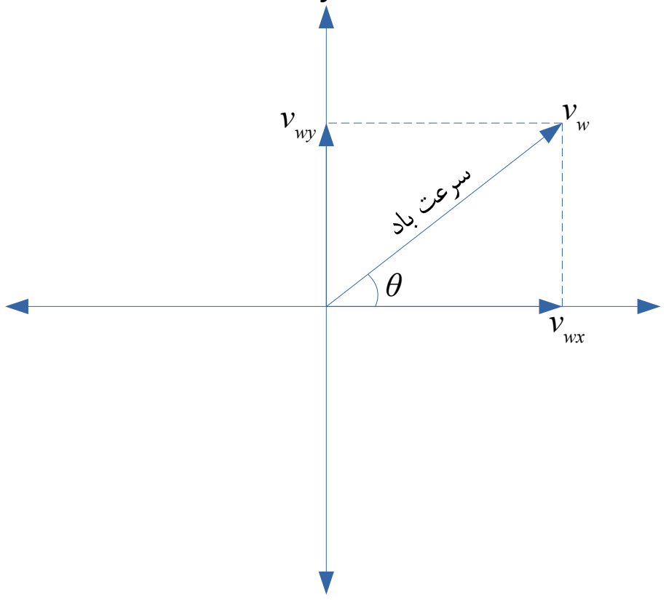
[picture p13: figure]
سرعت باد

x
