jmdmahdi/Weather-Station/Report/Assets/ultrasonic 2d.pdf

گیرنده فرستنده

فرستنده

گیرنده

وزش باد
