jmdmahdi/Weather-Station/PCB Design/Reciver/PCB_PCB_2020-07-24_15-45-59_2020-09-12_09-14-35.png

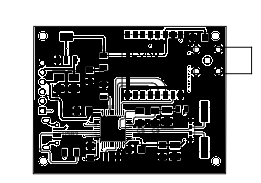
PCB Design/Reciver/PCB_PCB_2020-07-24_15-45-59_2020-09-12_09-14-35.png
