jmdmahdi/Weather-Station/PCB Design/Reciver/Schematic_weather station5_2020-09-12_09-13-48.png

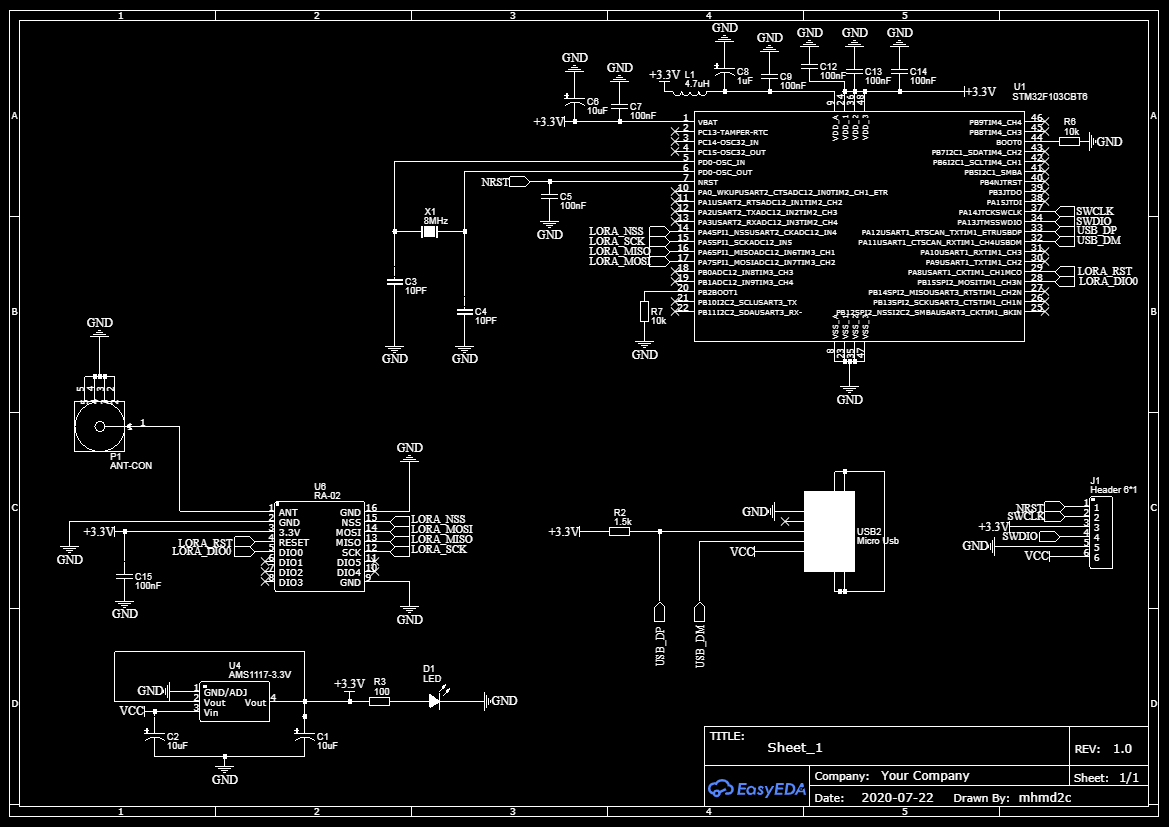
PCB Design/Reciver/Schematic_weather station5_2020-09-12_09-13-48.png
