jmdmahdi/Weather-Station/PCB Design/Transmiter/PCB_PCB_2020-07-26_21-29-46_2020-09-12_09-11-21.png

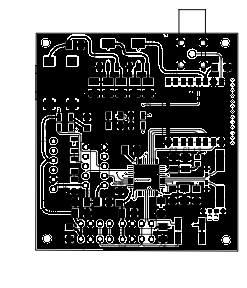
PCB Design/Transmiter/PCB_PCB_2020-07-26_21-29-46_2020-09-12_09-11-21.png
