jmdmahdi/Weather-Station/Report/Assets/desktopAppLog.png

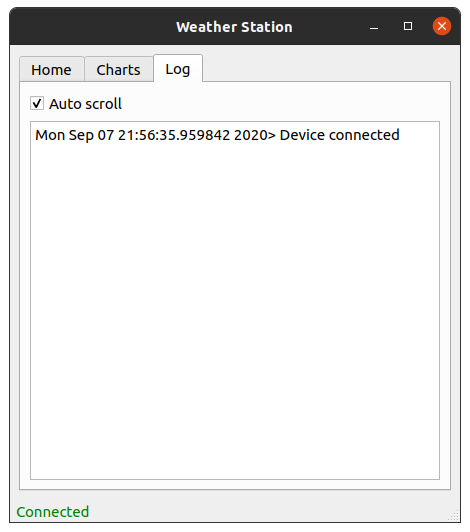
Report/Assets/desktopAppLog.png
