jmdmahdi/Weather-Station/Report/Assets/final image.png

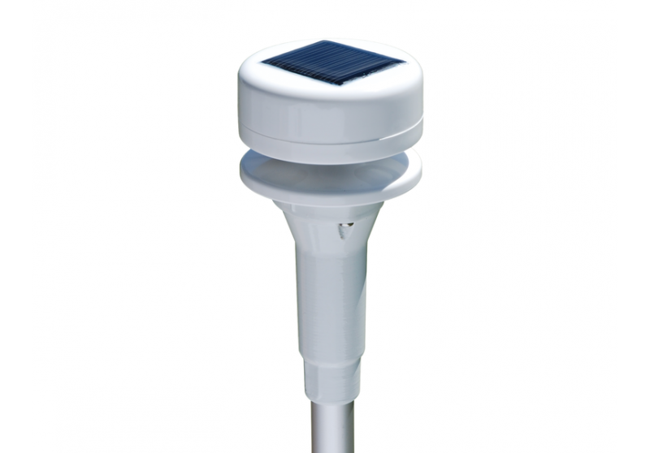
Report/Assets/final image.png
