jmdmahdi/Weather-Station/Report/Assets/wind speed and direction meter.png

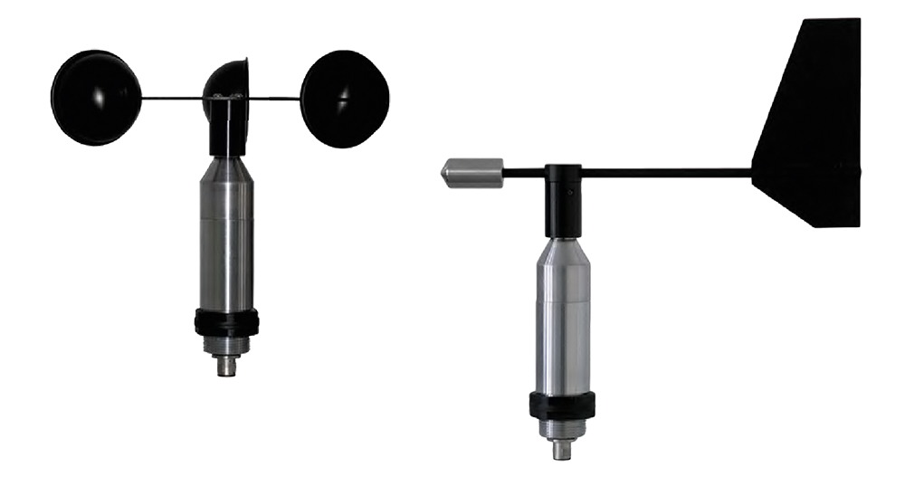
Report/Assets/wind speed and direction meter.png
