jmdmahdi/Weather-Station/Report/parts/pagetitle.tex

%!TeX root=../main.tex
\begin{center}
	\\
	\smallskip \LARGE
		{دانشگاه دامغان}\\
		{دانشکده فنی و مهندسی}\\
		
	\vspace{1cm} \LARGE
	\textbf{پایان نامه برای دریافت درجه کارشناسی\\مهندسی برق}\\
	
	\vspace{1cm}
	
	\huge
	\textbf{ایستگاه هواشناسی دیجیتال}
	
	\LARGE
	\vspace{3cm}
		{دانشجویان}\\
	\vspace{0.25cm}
	\textbf{مهدی جمشیدی\\محمدابراهیم ابراهیم‌طوسی}\\
	
	\vspace{1.2cm}
		{استاد راهنما}\\
	\vspace{0.25cm}
	\textbf{دکتر بهزاد بقراطی}
	
	\vfill
	{1399}
\end{center}
