jmdmahdi/Weather-Station/PCB Design/Reciver/BOM_weather station5_2020-09-12_09-14-12.csv

ID | Name | Designator | Footprint | Quantity | Manufacturer Part | Manufacturer | Supplier | Supplier Part | LCSC Assembly
1 | STM32F103CBT6 | U1 | LQFP-48_L7.0-W7.0-P0.50-LS9.0-BL | 1 | STM32F103CBT6 | STMicroelectronics | LCSC | C8304 | Yes
2 | Header 6*1 | J1 | HDR-TH_6P-P2.54-H-W10.0 | 1 | 2.54-1*6PHeader | BOOMELE | LCSC | C56816
3 | 100nF | C14,C13,C12,C15,C5,C7,C9 | 1206 | 7 | C1206X224K251T 3K | HEC | LCSC | C106050
4 | Micro Usb | USB2 | MICRO-USB-SMD_MICRO-USB-18 | 1 | U-F-M5DD-Y-L | HRO | LCSC | C91146
5 | ANT-CON | P1 | SMA-KWE | 1 | SMA-KWE | LCSC | LCSC | C58326
6 | LED | D1 | LED1206-R-RD | 1 | KT-1206Red LED | KENTO | LCSC | C49018 | Yes
7 | AMS1117-3.3V | U4 | SOT-223-3_L6.5-W3.4-P2.30-LS7.0-BR | 1 | AMS1117-3.3 | AMS | LCSC | C6186 | Yes
8 | RA-02 | U6 | WIRELM-SMD_RA-02 | 1 | Ra-02 | Ai-Thinker | LCSC | C90039
9 | 10PF | C3,C4 | 0603 | 2
10 | 100 | R3 | R1206 | 1 | QR1206J100RP05 | Ever Ohms Tech | LCSC | C176249
11 | 10k | R6,R7 | R1206 | 2 | QR1206J100RP05 | Ever Ohms Tech | LCSC | C176249
12 | 8MHz | X1 | HC-49US-SMD | 1
13 | 10uF | C2,C1,C6 | CAP-SMD_L3.5-W2.8-R-RD | 3 | CA45-B-10V-100uF-M | Shenzhen Zhenhua XinYun Elec | LCSC | C140381 | Yes
14 | 1uF | C8 | CAP-SMD_L3.5-W2.8-R-RD | 1 | CA45-B-10V-100uF-M | Shenzhen Zhenhua XinYun Elec | LCSC | C140381 | Yes
15 | 1.5k | R2 | R1206 | 1 | 1206W4F1200T5E | UniOhm | LCSC | C14661
16 | 4.7uH | L1 | L0805 | 1 | 0805F-4R7K-1LRH | Prosperity Dielectrics | LCSC | C329433
