jmdmahdi/Weather-Station/Report/parts/bibliography.tex

%!TeX root=../main.tex
\singlespacing
\clearpage
\phantomsection
\fancyhead[L]{\fontsize{14}{15} \selectfont مراجع}
\addcontentsline{toc}{chapter}{مراجع}
\bibliography{lib}
