jmdmahdi/Weather-Station/Report/Assets/Schematic_Reciver.pdf

A | A

1

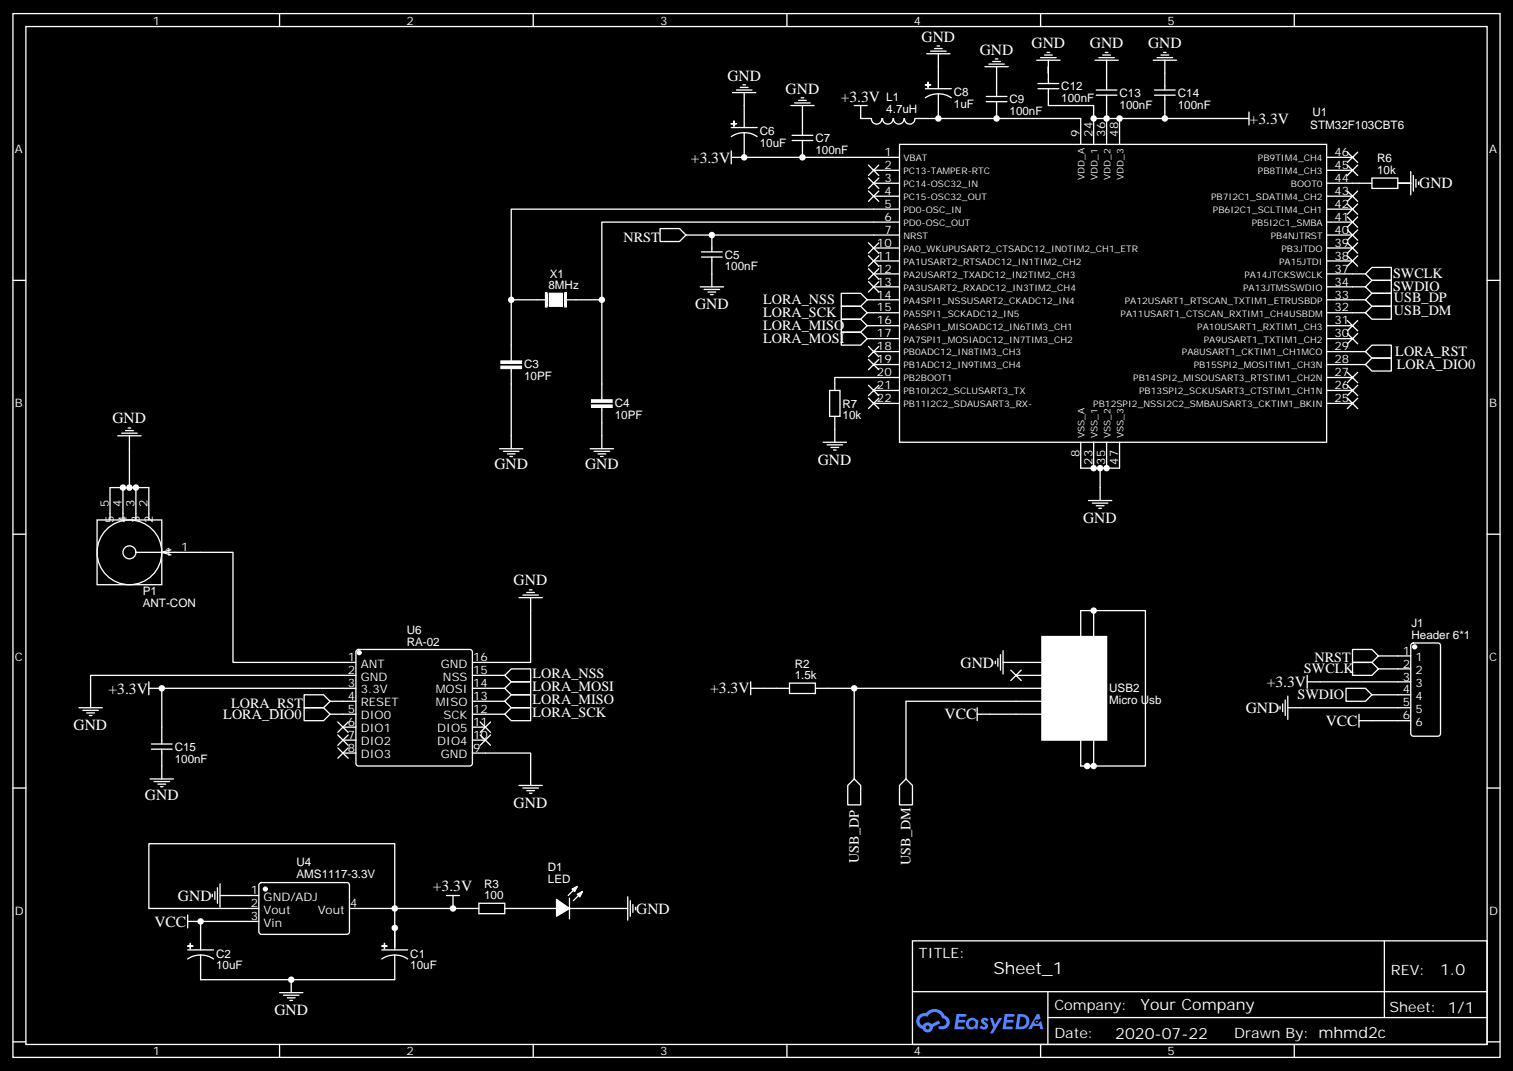
[picture p73: page 1]

DIO4 10 DIO5 11 SCK 12 MISO 13 MOSI 14 NSS 15 GND 16
