jmdmahdi/Weather-Station/Report/Assets/Schematic_Transmiter.pdf

A | A

1

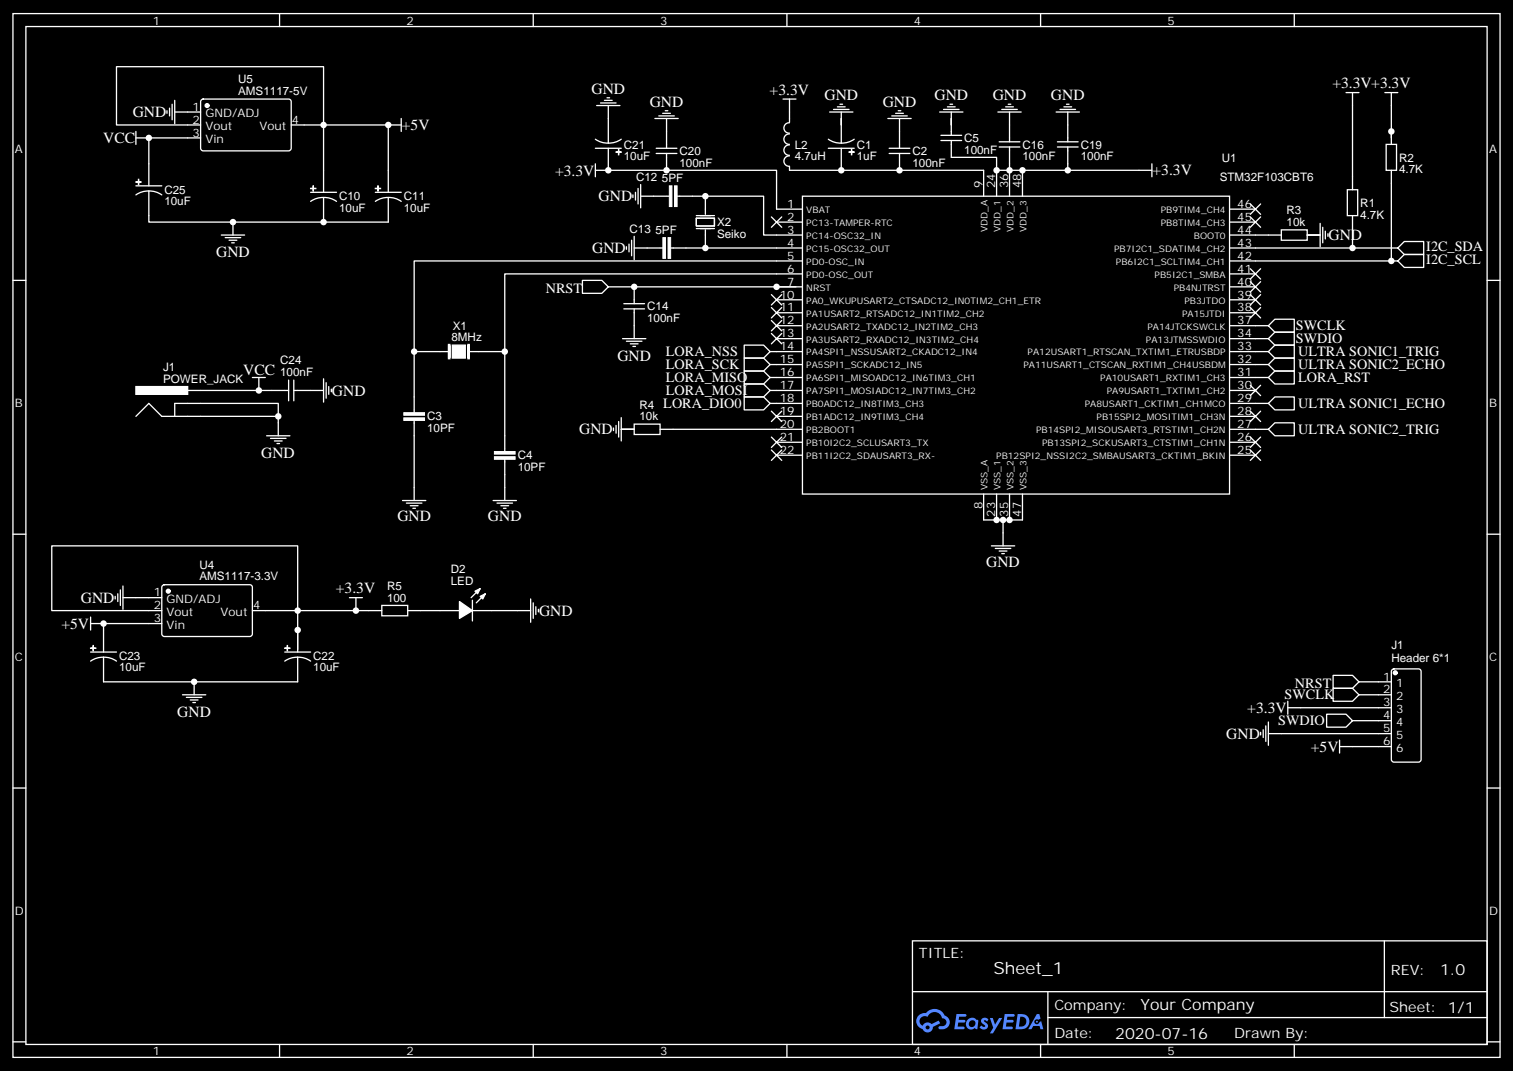
[picture p74: page 1]

A

A

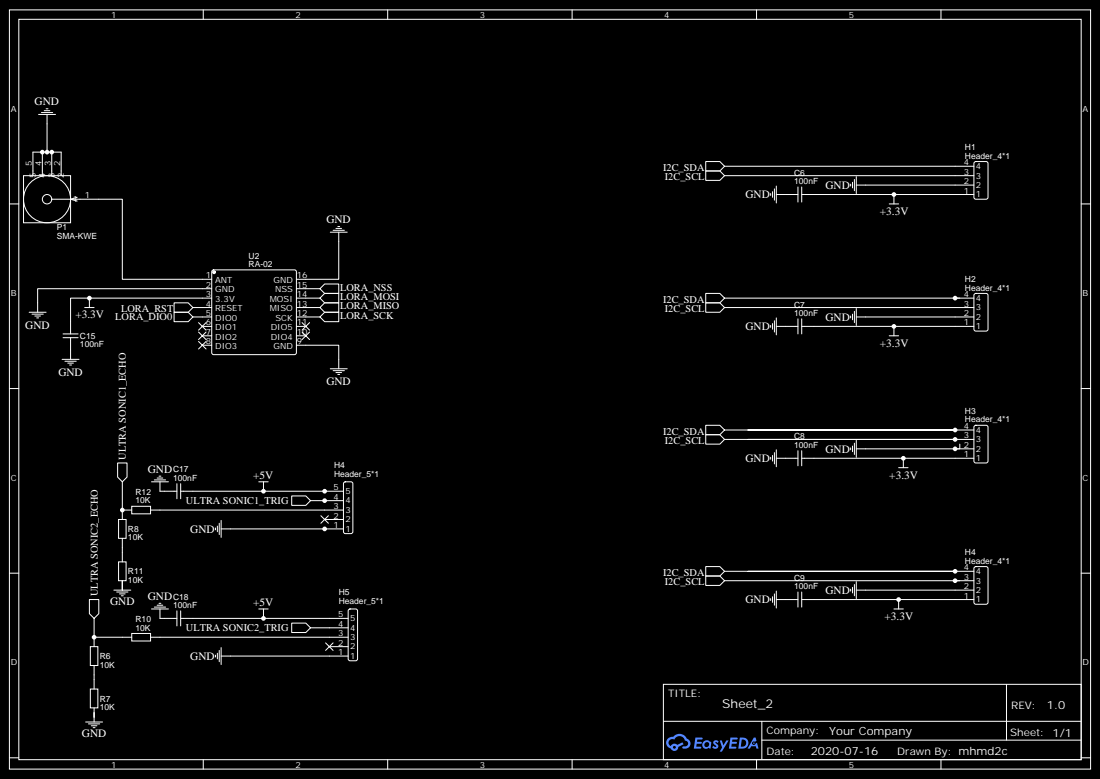
[picture p75: page 2]

DIO4 10 DIO5 11 SCK 12 MISO 13 MOSI 14 NSS 15 GND 16
