jmdmahdi/Weather-Station/Report/Assets/SensorFlowChart.pdf

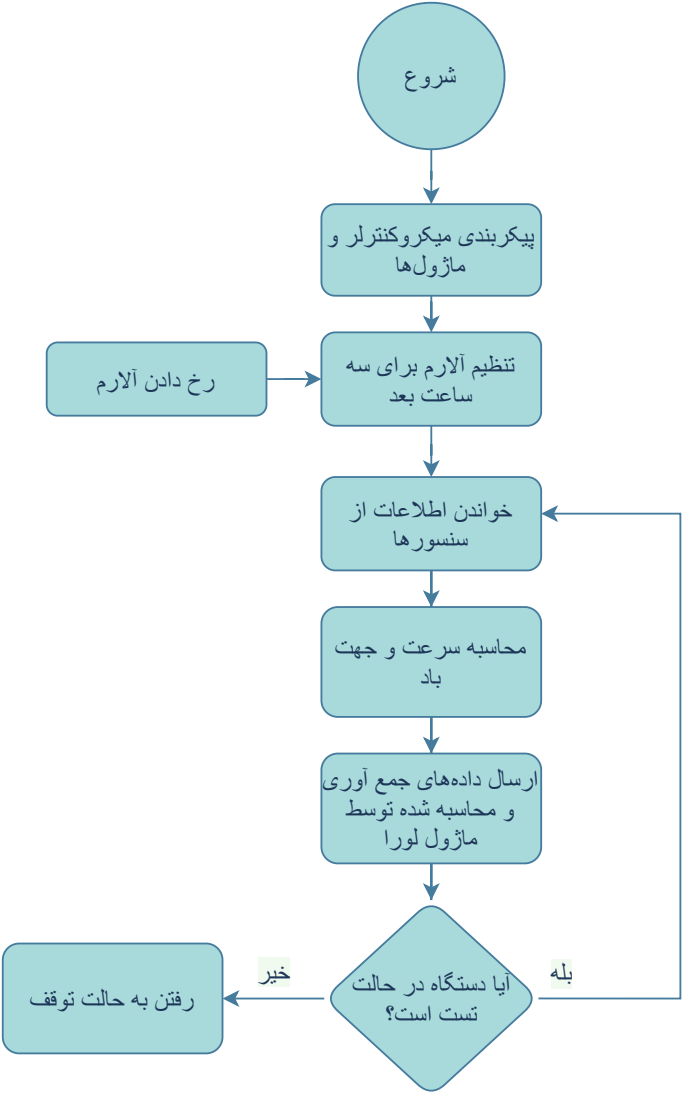
[picture p76: page 1]
پیکربندی میکروکنترلر و ماژولھا; باد; آیا دستگاه در حالت; بلھ خیر; رفتن بھ حالت توقف; تست است؟; شروع

تنظیم آلارم برای سھ
ساعت بعد

رخ دادن آلارم

خواندن اطلاعات از
سنسورھا

محاسبھ سرعت و جھت

ارسال دادهھای جمع آوری
و محاسبھ شده توسط
ماژول لورا
