jmdmahdi/Weather-Station/Report/Assets/StationFlowChart.pdf

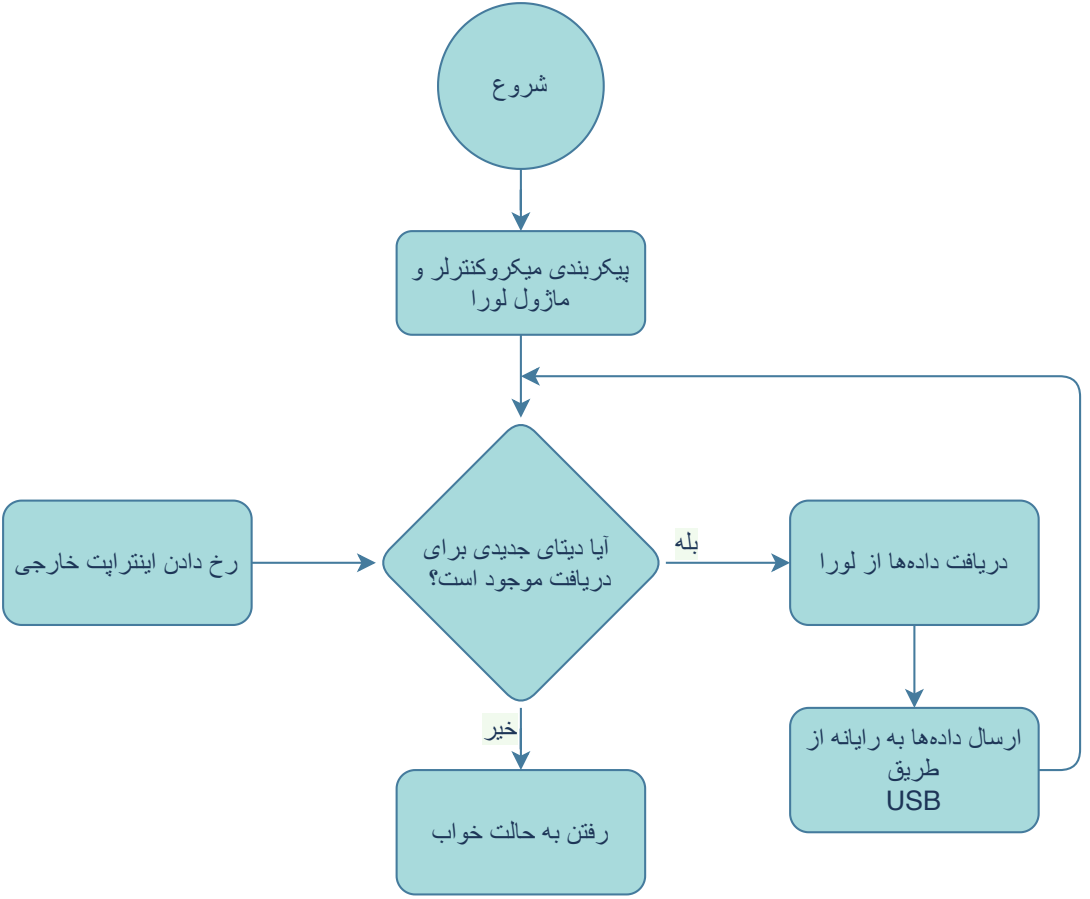
[picture p77: page 1]
پیکربندی میکروکنترلر و ماژول لورا; شروع; خیر; آیا; بلھ دیتای جدیدی برای

دریافت موجود است؟

رخ دادن اینتراپت خارجی

دریافت دادهھا از لورا

ارسال دادهھا بھ رایانھ از
طریق
USB

رفتن بھ حالت خواب
