jmdmahdi/Weather-Station/Report/Assets/USBFlowChart.pdf

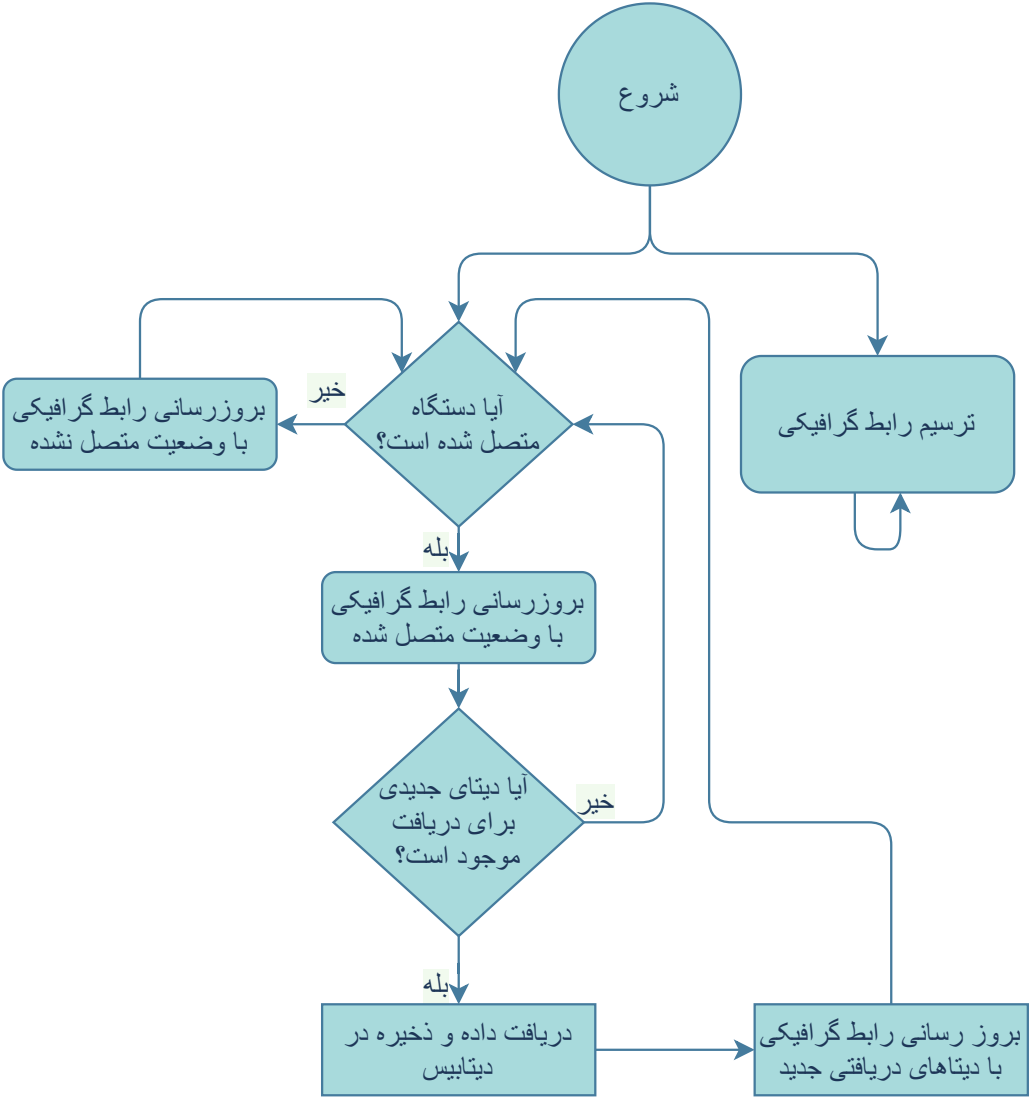
[picture p78: page 1]
شروع; خیر

آیا دستگاه خیر
متصل شده است؟

بروزرسانی رابط گرافیکی
با وضعیت متصل نشده

ترسیم رابط گرافیکی

بلھ
با وضعیت متصل شده

آیا دیتای جدیدی
برای دریافت
موجود است؟

دریافت داده و ذخیره در
دیتابیس

بروز رسانی رابط گرافیکی
با دیتاھای دریافتی جدید
