jmdmahdi/Weather-Station/Report/Assets/PCB_Reciver.pdf

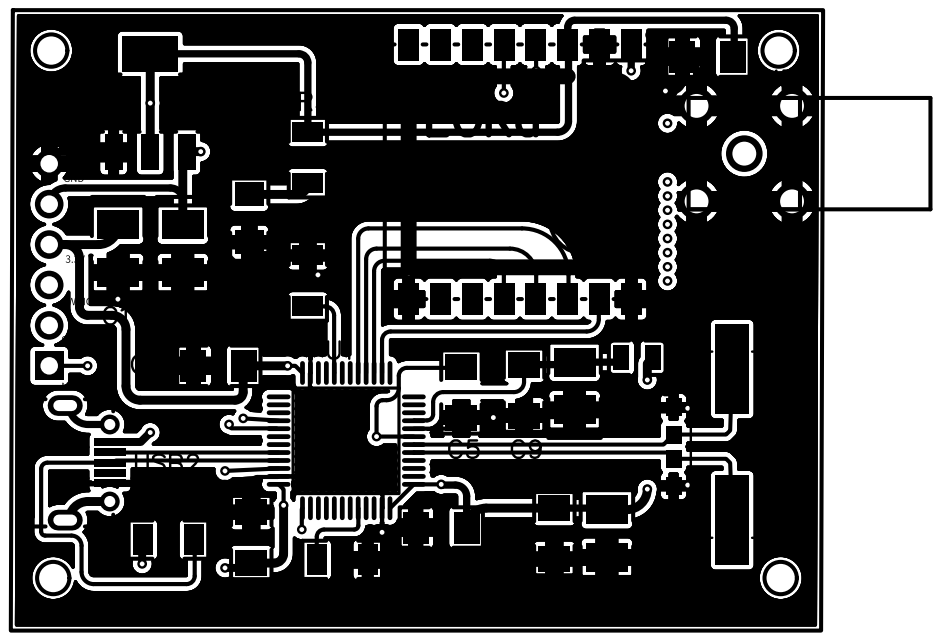
[picture p79: page 1]
