jmdmahdi/Weather-Station/Report/Assets/PCB_Transmiter.pdf

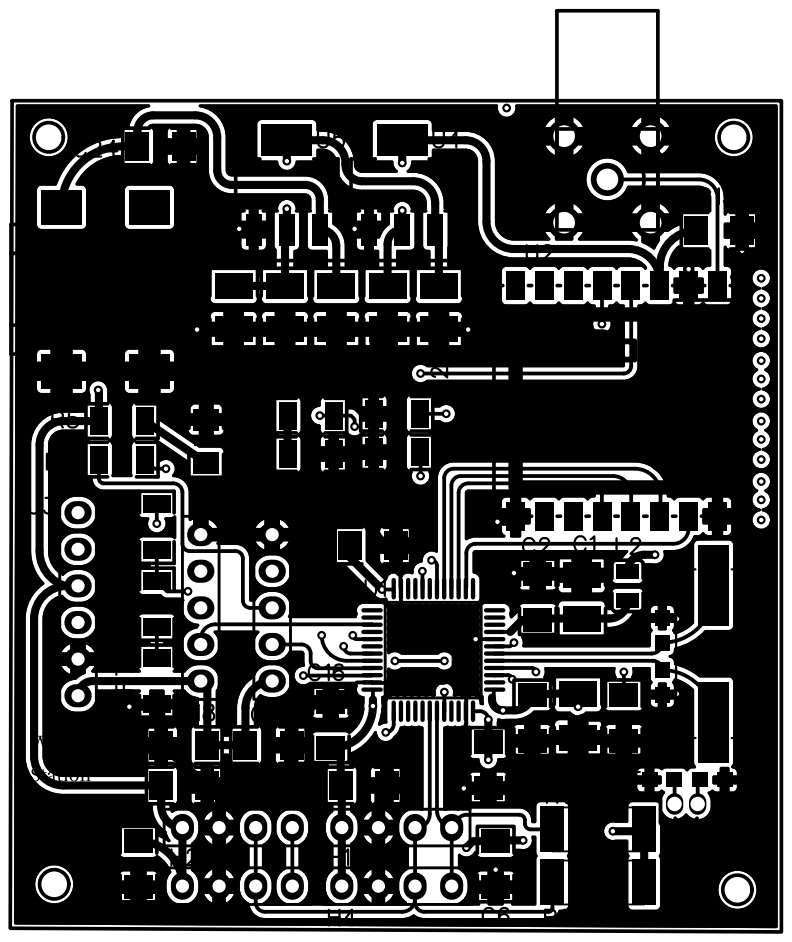
[picture p80: page 1]
