jmdmahdi/Weather-Station/Report/Assets/I2C.pdf

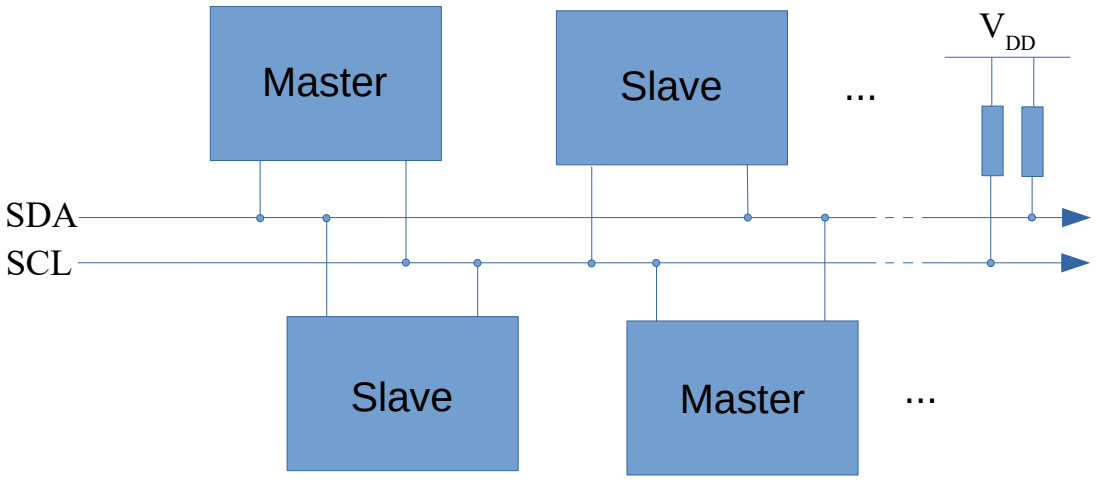
[picture p81: page 1]
SDA SCL; Master; Slave; VDD
