jmdmahdi/Weather-Station/Report/Assets/SPI.pdf

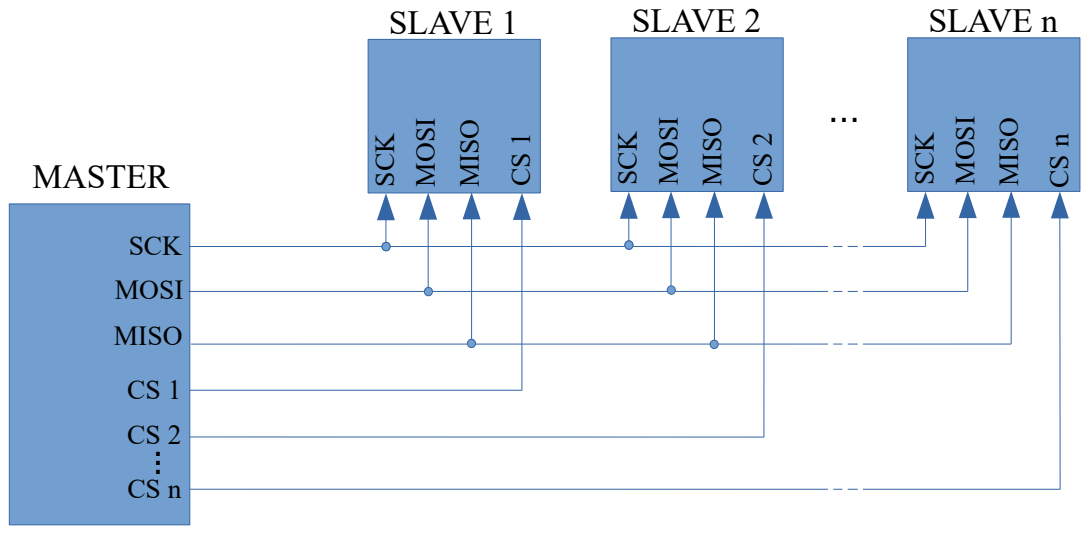
[picture p82: page 1]
MASTER; SLAVE 1; SCK; MOSI; MISO; MIS; SLAVE 2; SLAVE n
