jmdmahdi/Weather-Station/Report/Assets/logo.pdf

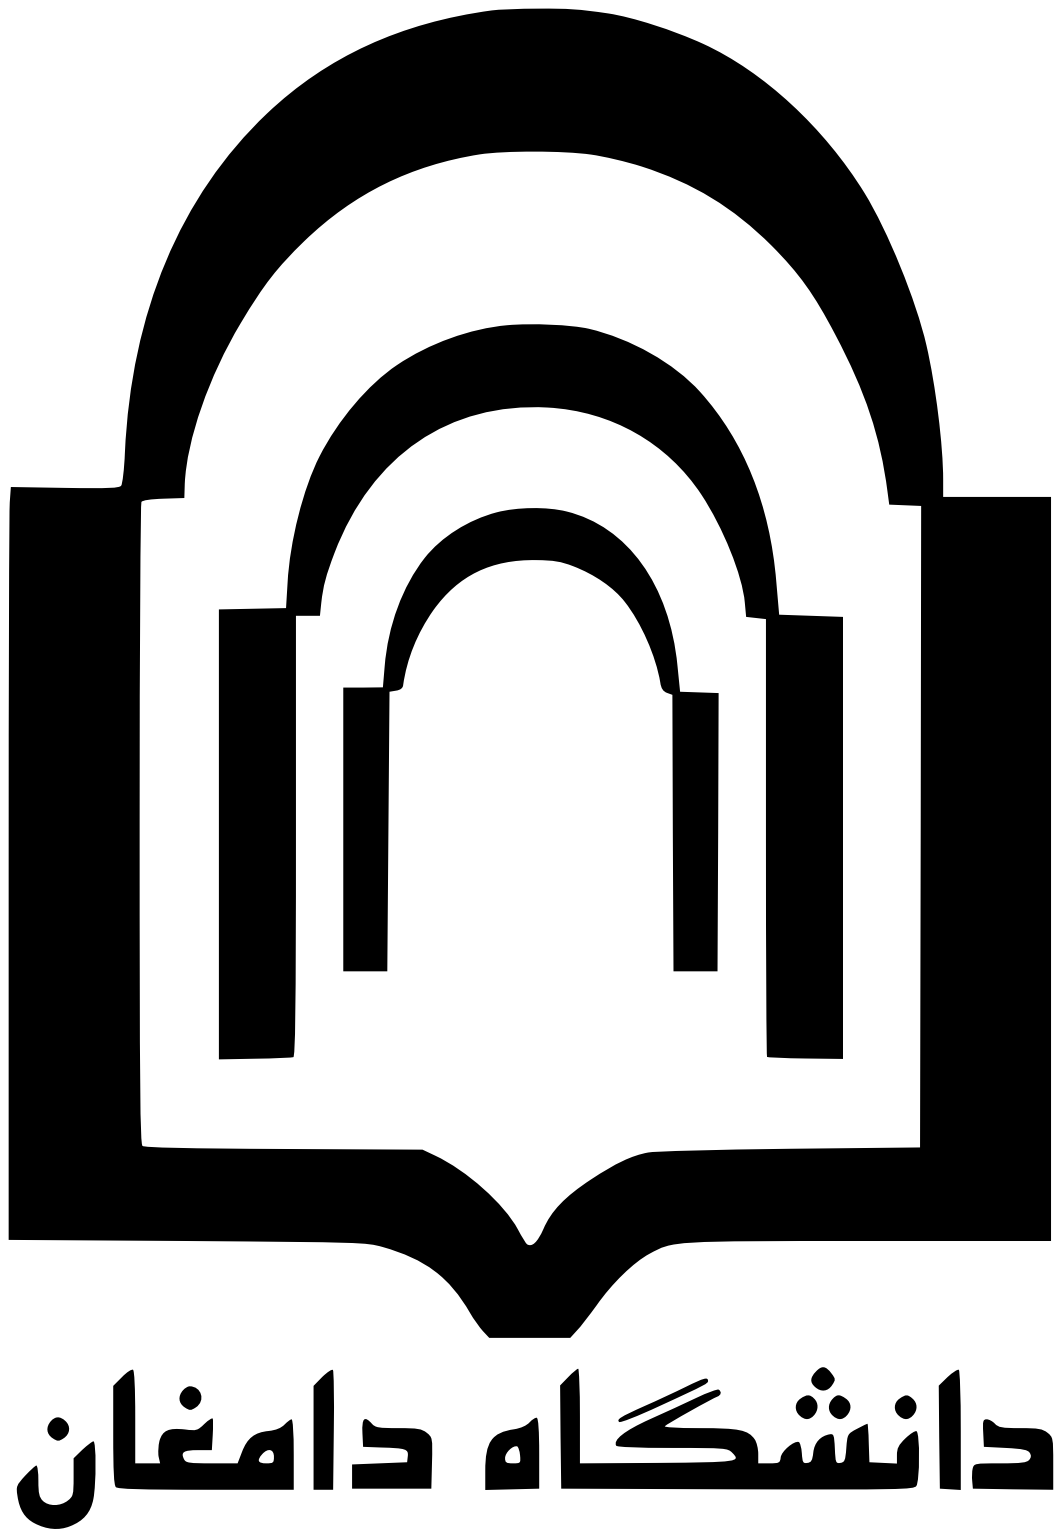
[picture p83: page 1]
