jmdmahdi/Weather-Station/(list of files, drawings)

Other design files:
PCB Design/Reciver/PCB_2020-07-24_15-45-59_2020-09-12_09-14-54.pcbdoc
PCB Design/Reciver/Weather Station Reciver_Shematic_2020-09-12_09-13-56.schdoc
PCB Design/Transmiter/PCB_2020-07-26_21-29-46_2020-09-12_09-12-22.pcbdoc
