jmdmahdi/Weather-Station/Report/Code/Sensor/main.c

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

/* Includes ------------------------------------------------------------------*/
#include "main.h"

/* USER CODE BEGIN Includes */
#include <string.h>
#include "BMP180.h"
#include "MAX44009.h"
#include "AHT10.h"
#include "QMC5883L.h"
#include "HCSR05.h"
#include "SX1278.h"
/* USER CODE END Includes */

/* USER CODE BEGIN PD */

// Transducers distance
#define HCSR05_DISTANCE 6

// Angle difference between wind sensor x axis and compass x axis
#define HCSR05_ANGLE_DIFFERENCE 0

// LoRa device id
#define DEVICE_ID 12345

/* USER CODE END PD */

I2C_HandleTypeDef hi2c1;

RTC_HandleTypeDef hrtc;

SPI_HandleTypeDef hspi1;

TIM_HandleTypeDef htim1;

/* USER CODE BEGIN PV */
float BMP180_Temperature, lux;
int32_t BMP180_Pressure;
int16_t compass_x, compass_y, compass_z;
int8_t TempHum[2];
float_t X_axis_wind_speed = 0;
float_t Y_axis_wind_speed = 0;
float_t wind[2];
float TXData[8];
uint8_t Buffer[32];
SX1278_hw_t SX1278_hw;
SX1278_t SX1278;
/* USER CODE END PV */

void SystemClock_Config(void);
static void MX_GPIO_Init(void);
static void MX_I2C1_Init(void);
static void MX_RTC_Init(void);
static void MX_SPI1_Init(void);
static void MX_TIM1_Init(void);
/**
 * @brief  The application entry point.
 * @retval int
 */
int main(void) {
	/* MCU Configuration--------------------------------------------------------*/

	/* Reset of all peripherals, Initializes the Flash interface and the Systick. */
	HAL_Init();

	/* Configure the system clock */
	SystemClock_Config();

	/* Initialize all configured peripherals */
	MX_GPIO_Init();
	MX_I2C1_Init();
	MX_RTC_Init();
	MX_SPI1_Init();
	MX_TIM1_Init();
	/* USER CODE BEGIN 2 */

	//BMP180 init
	BMP180_Init(&hi2c1);
	BMP180_SetOversampling(BMP180_LOW);
	BMP180_UpdateCalibrationData();

	// MAx44009 init
	MAX44009_Begin(&hi2c1);

	// HMC5883L init
	QMC5883L_Init(&hi2c1);
	QMC5883L_Set_Sampling_Rate(50);

	// AHT10 init
	AHT10_Init(&hi2c1);

	// HCSR05 delay init
	HCSR05_Init();

	// Initialize LoRa
	SX1278_hw.dio0.port = LoRa_DIO_GPIO_Port;
	SX1278_hw.dio0.pin = LoRa_DIO_Pin;
	SX1278_hw.nss.port = LoRa_NSS_GPIO_Port;
	SX1278_hw.nss.pin = LoRa_NSS_Pin;
	SX1278_hw.reset.port = LoRa_RST_GPIO_Port;
	SX1278_hw.reset.pin = LoRa_RST_Pin;
	SX1278_hw.spi = &hspi1;
	SX1278.hw = &SX1278_hw;
	SX1278_begin(&SX1278, SX1278_433MHZ, SX1278_POWER_20DBM, SX1278_LORA_SF_10,
			SX1278_LORA_BW_250KHZ, 32);

	SX1278_LoRaEntryTx(&SX1278, 32, 2000);

	// Setting TXData constant values
	TXData[0] = DEVICE_ID; // Sender device id
	TXData[1] = 65535; // Receiver device id

	/* USER CODE END 2 */

	/* Infinite loop */
	/* USER CODE BEGIN WHILE */
	while (1) {
		// Reads temperature.
		BMP180_Temperature = BMP180_GetTemperature();
		// Setting TXData
		TXData[2] = BMP180_Temperature; // Temperature

		// Reads pressure.
		BMP180_Pressure = BMP180_GetPressure();
		// Setting TXData
		TXData[3] = BMP180_Pressure; // Pressure

		// Reads light intensity.
		lux = MAX44009_Get_Lux();
		// Setting TXData
		TXData[4] = lux; // Light intensity

		// Reads temperature and hum.
		AHT10_GetTemperature_hum(TempHum);
		// Setting TXData
		TXData[5] = TempHum[1]; // Humidity

		// Reads compass.
		QMC5883L_ReadRaw(&compass_x, &compass_y, &compass_z);

		// Get X axis wind speed
		HCSR05_Ready(X_axis_echo_GPIO_Port, X_axis_echo_Pin, &htim1,
				TIM_CHANNEL_1, HCSR05_DISTANCE, HCSR05_ANGLE_DIFFERENCE);
		X_axis_wind_speed = HCSR05_Get_WindSpeed((int8_t) BMP180_Temperature,
				(uint32_t) BMP180_Pressure, (int8_t) TempHum[1]);

		// Get Y axis wind speed
		HCSR05_Ready(Y_axis_echo_GPIO_Port, Y_axis_echo_Pin, &htim1,
				TIM_CHANNEL_2, HCSR05_DISTANCE, HCSR05_ANGLE_DIFFERENCE);
		Y_axis_wind_speed = HCSR05_Get_WindSpeed((int8_t) BMP180_Temperature,
				(uint32_t) BMP180_Pressure, (int8_t) TempHum[1]);

		// Calculate wind speed and direction
		HCSR05_Calculate_WindSpeedNdAngle(X_axis_wind_speed, Y_axis_wind_speed,
				compass_x, compass_y, wind);
		// Setting TXData
		TXData[6] = wind[0]; // Wind speed
		TXData[7] = wind[1]; // Wind direction

		// Transmit TXData
		memcpy(Buffer, TXData, sizeof(TXData));
		SX1278_transmit(&SX1278, Buffer, sizeof(Buffer), 3000);

		// Check workingMode pin status
		// GPIO_PIN_SET: Normal working mode
		// GPIO_PIN_RESET: Continuous mode
		if (HAL_GPIO_ReadPin(workingMode_GPIO_Port, workingMode_Pin)
				== GPIO_PIN_SET) {
			// It is on normal working mode

			/* Taking a rest after a hard work */

			// Put LoRa to sleep
			SX1278_sleep(&SX1278);

			// Put compass to sleep
			QMC5883L_Sleep();

			// Other sensors are in sleep mode by default

			// Stop tick to reduce MCU power usage
			HAL_SuspendTick();
			// Enter stop mode and wait until interrupt occurred
			HAL_PWR_EnterSTOPMode(PWR_LOWPOWERREGULATOR_ON, PWR_STOPENTRY_WFI);

			// After alarm interrupt
			// Reset RTC
			MX_RTC_Init();
		}

		/* USER CODE END WHILE */

		/* USER CODE BEGIN 3 */
	}
	/* USER CODE END 3 */
}

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
/* USER CODE BEGIN 4 */

/**
 * @brief Timer Capture Callback
 * @param htim
 * @retval None
 */
void HAL_TIM_IC_CaptureCallback(TIM_HandleTypeDef *htim) {
	HCSR05_TIM_Callback(htim);
}

/**
 * @brief Alarm Event Callback Function
 * @param hrtc
 * @retval None
 */
void HAL_RTC_AlarmAEventCallback(RTC_HandleTypeDef *hrtc) {
	SystemClock_Config();
	HAL_ResumeTick();
}

/* USER CODE END 4 */
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
