jmdmahdi/Weather-Station/Codes/Sensor/Sensor.ioc

Mcu.UserName=STM32F107VCTx
PA13.Signal=SYS_JTMS-SWDIO
PA14.Signal=SYS_JTCK-SWCLK
PA4.GPIO_Label=LoRa_NSS
PA4.Signal=GPIO_Output
PA5.Signal=SPI1_SCK
PA6.Signal=SPI1_MISO
PA7.Signal=SPI1_MOSI
PB3.Signal=SYS_TRACESWO
PB8.Signal=I2C1_SCL
PB9.Signal=I2C1_SDA
PC13-TAMPER-RTC.Signal=RTC_OUT
PC14-OSC32_IN.Signal=RCC_OSC32_IN
PC15-OSC32_OUT.Signal=RCC_OSC32_OUT
PC4.GPIO_Label=LoRa_RST
PC4.Signal=GPIO_Output
PC5.GPIO_Label=LoRa_DIO
PC5.Signal=GPIO_Input
PC6.GPIO_Label=workingMode
PC6.Signal=GPIO_Input
PE10.GPIO_Label=X_axis_trigger
PE10.Signal=GPIO_Output
PE11.GPIO_Label=Y_axis_echo
PE11.Signal=S_TIM1_CH2
PE12.GPIO_Label=Y_axis_trigger
PE12.Signal=GPIO_Output
PE9.GPIO_Label=X_axis_echo
PE9.Signal=S_TIM1_CH1
