jmdmahdi/Weather-Station/Report/Code/Sensor/main.h

#define LoRa_NSS_Pin GPIO_PIN_4
#define LoRa_NSS_GPIO_Port GPIOA
#define LoRa_RST_Pin GPIO_PIN_4
#define LoRa_RST_GPIO_Port GPIOC
#define LoRa_DIO_Pin GPIO_PIN_5
#define LoRa_DIO_GPIO_Port GPIOC
#define X_axis_echo_Pin GPIO_PIN_9
#define X_axis_echo_GPIO_Port GPIOE
#define X_axis_trigger_Pin GPIO_PIN_10
#define X_axis_trigger_GPIO_Port GPIOE
#define Y_axis_echo_Pin GPIO_PIN_11
#define Y_axis_echo_GPIO_Port GPIOE
#define Y_axis_trigger_Pin GPIO_PIN_12
#define Y_axis_trigger_GPIO_Port GPIOE
#define workingMode_Pin GPIO_PIN_6
#define workingMode_GPIO_Port GPIOC
