jmdmahdi/Weather-Station/Report/Code/DesktopApp/worker.py

import sys
from PyQt5.QtCore import *
import traceback
from Worker.workerSignals import WorkerSignals


class Worker(QRunnable):
    '''
    Worker thread

    Inherits from QRunnable to handler worker thread setup, signals and wrap-up.

    :param callback: The function callback to run on this worker thread. Supplied args and
                     kwargs will be passed through to the runner.
    :type callback: function
    :param args: Arguments to pass to the callback function
    :param kwargs: Keywords to pass to the callback function

    '''

    def __init__(self, fn, *args, **kwargs):
        super(Worker, self).__init__()

        # Store constructor arguments (re-used for processing)

        self.fn = fn
        self.args = args
        self.kwargs = kwargs
        self.signals = WorkerSignals()

        # Add the callback to our kwargs
        self.kwargs['process_callback'] = self.signals.progress
        self.kwargs['UIUpdateCallBack'] = self.signals.statusbar

    @pyqtSlot()
    def run(self):
        '''
        Initialise the runner function with passed args, kwargs.
        '''

        # Retrieve args/kwargs here; and fire processing using them
        try:
            self.fn(*self.args, **self.kwargs)
        except:
            traceback.print_exc()
            exctype, value = sys.exc_info()[:2]
            self.signals.error.emit((exctype, value, traceback.format_exc()))
