jmdmahdi/Weather-Station/Report/Code/DesktopApp/signalWakeupHandler.py

import sys, signal, socket
from PyQt5.QtCore import *
from PyQt5.QtNetwork import *


class SignalWakeupHandler(QAbstractSocket):

    def __init__(self, parent=None):
        super().__init__(QAbstractSocket.UdpSocket, parent)
        self.old_fd = None
        # Create a socket pair
        self.wsock, self.rsock = socket.socketpair(type=socket.SOCK_STREAM)
        # Let Qt listen on the one end
        self.setSocketDescriptor(self.rsock.fileno())
        # And let Python write on the other end
        self.wsock.setblocking(False)
        self.old_fd = signal.set_wakeup_fd(self.wsock.fileno())
        # First Python code executed gets any exception from
        # the signal handler, so add a dummy handler first
        self.readyRead.connect(lambda: None)
        # Second handler does the real handling
        self.readyRead.connect(self._readSignal)

    def __del__(self):
        # Restore any old handler on deletion
        if self.old_fd is not None and signal and signal.set_wakeup_fd:
            signal.set_wakeup_fd(self.old_fd)

    def _readSignal(self):
        # Read the written byte.
        # Note: readyRead is blocked from occuring again until readData()
        # was called, so call it, even if you don't need the value.
        data = self.readData(1)
        # Emit a Qt signal for convenience
        self.signalReceived.emit(data[0])

    signalReceived = pyqtSignal(int)
