jmdmahdi/Weather-Station/(commit log)

2020-06-23 Sensor initial commit
2020-06-23 Added QMC5883L(compass) sensor
2020-06-24 Added AHT10 sensor
2020-08-21 Added LoRa wireless data transmission
2020-09-01 Fixed USB transmission issue
    [main.c]
2020-09-06 Report - Added PCB design description
2020-09-08 Report - PCB design updated
2020-09-09 Desktop app - Fixed chart issues
    [chartWidget.py, db.py, main.py, worker.py, workerSignals.py]
2020-09-12 add the pcb file
    [BOM_weather station5_2020-09-12_09-14-12.csv, PCB_2020-07-24_15-45-59_2020-09-12_09-14-54.pcbdoc, PCB_2020-07-26_21-29-46_2020-09-12_09-12-22.pcbdoc, Weather Station Reciver_Shematic_2020-09-12_09-13-56.schdoc]
2020-09-12 add the power point
2020-09-14 Desktop app - Fixed closing application issues
    [main.py, signalWakeupHandler.py]
2020-09-15 Desktop app - Fixed PyUSB backend issue on windows
    [main.py]
2020-09-16 Fixed USB and LoRa transmissions data type
    [main.c, main.py, signalWakeupHandler.py, worker.py, workerSignals.py]
